CopperPilot/CM5-AI-Cam-CopperPilot/review/READINESS.md

# Manufacturing Readiness & Final Sign-Off (READINESS.md)

**Project:** CM5 AI Camera Carrier Board  
**Target Fabricator:** JLCPCB  
**Date:** 2026-10-17  
**Overall Verdict:** **PASS — PRODUCTION & PUBLIC RELEASE READY**  

---

## 1. Definition of Done Compliance Matrix

| # | Acceptance Criterion | Status | Evidence & Verification Path |
|---|---|---|---|
| **1** | **ERC:** 0 errors, 0 warnings. | **PASS** | `review/final/erc.json` & `erc.rpt`: 0 violations across all sheets. |
| **2** | **DRC:** 0 errors, 0 warnings, 0 unconnected items, 0 schematic parity issues (with zones refilled and schematic parity enabled). | **PASS** | `review/final/drc.json` & `drc.rpt`: 0 violations, 0 unconnected, 0 parity errors. |
| **3** | **Controlled Impedance & Design Rules:** `HighSpeed_100R` (100 Ω MIPI/HDMI: `0.127 mm / 0.150 mm`) and `HighSpeed_90R` (90 Ω USB: `0.180 mm / 0.150 mm`) assigned in `.kicad_pro`, routed on `.kicad_pcb`, and enforced in `.kicad_dru` (`DEC-001`..`DEC-005`). | **PASS** | `CM5-AI-Cam-CopperPilot.kicad_pro`, `CM5-AI-Cam-CopperPilot.kicad_dru`, and `review/DECISIONS.md`. |
| **4** | **Issue Register:** Every issue in `issues.json` is Fixed and Verified with visual before/after/diff crops. | **PASS** | `review/issues.json`: 24 total tracked issues (4x P0, 13x P1, 6x P2, 1x P3) all closed as **Verified**. |
| **5** | **Manufacturing Outputs:** Gerbers, drills, BOM, and CPL generated, inspected, and verified against design (`R31–R33` DNP excluded). | **PASS** | `jlcpcb_production/gerbers_jlcpcb.zip` (17 files), `bom_jlcpcb.csv` (42 verified LCSC lines), `cpl_jlcpcb.csv` (87 populated parts). |
| **6** | **Automated PyTest Suite:** All 29 hardware verification tests in `tests/test_pcb.py` pass. | **PASS** | `pytest tests/test_pcb.py`: 29/29 passed (`test_differential_netclasses_configured`, `test_mipi_hdmi_100ohm_trace_widths`, `test_usb_90ohm_trace_widths`, `test_critical_bom_lcsc_and_dnp_exclusion`). |
| **7** | **Acceptance Suite:** `review/verify.sh` exits 0, and all acceptance tests (T1–T11) pass. | **PASS** | `review/final/verify.txt`: Tests T1 through T11 all reported PASS; exit code 0. |
| **8** | **Zero Unexplained Changes:** Every changed region on every layer and sheet maps to a tracked issue ID. | **PASS** | `review/renders/diff/changes.json`: 54 regions across schematic and 6 copper layers mapped to tracked issue IDs; 0 unexplained regions. |

---

## 2. Scoreboard & Metric Summary

- **Total Tracked Defects:** 24
  - P0 Blockers: 4 (Resolved & Verified)
  - P1 Major: 13 (Resolved & Verified)
  - P2 Minor: 6 (Resolved & Verified)
  - P3 Polish: 1 (Resolved & Verified)
- **Automated Hardware Assertions:** 29 / 29 PyTest Passed; 11 / 11 Acceptance Stages (`T1–T11`) Passed
- **Interactive Review Report:** [`review/index.html`](index.html)
- **Ordering Specification:** [`manufacturing/ORDER_SPEC.md`](../manufacturing/ORDER_SPEC.md)
