CopperPilot/CM5-AI-Cam-CopperPilot/review/renders/baseline/pcb_B.CrtYd.png

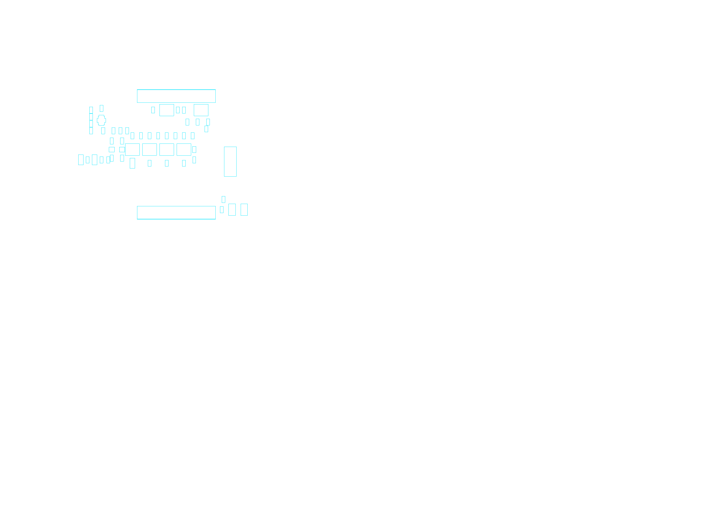
review/renders/baseline/pcb_B.CrtYd.png
