CopperPilot/CM5-AI-Cam-CopperPilot/review/renders/baseline/pcb_Edge.Cuts.png

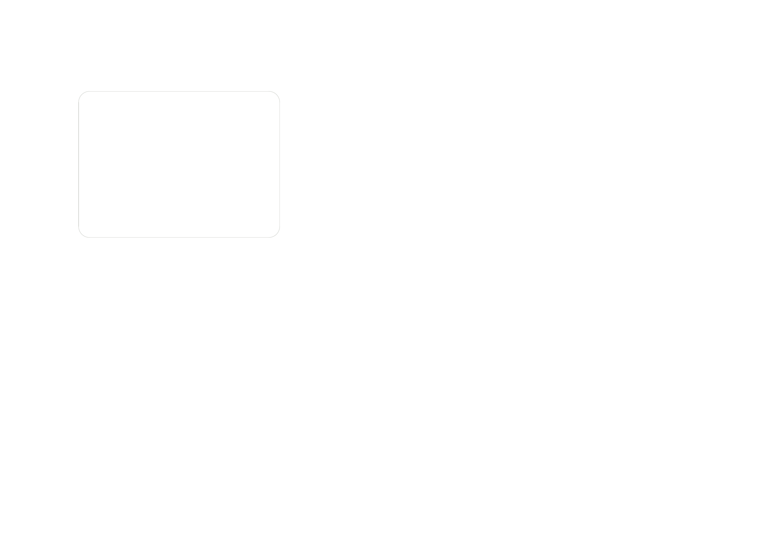
review/renders/baseline/pcb_Edge.Cuts.png
