CopperPilot/CM5-AI-Cam-CopperPilot/review/renders/baseline/sch_sheet_1.png

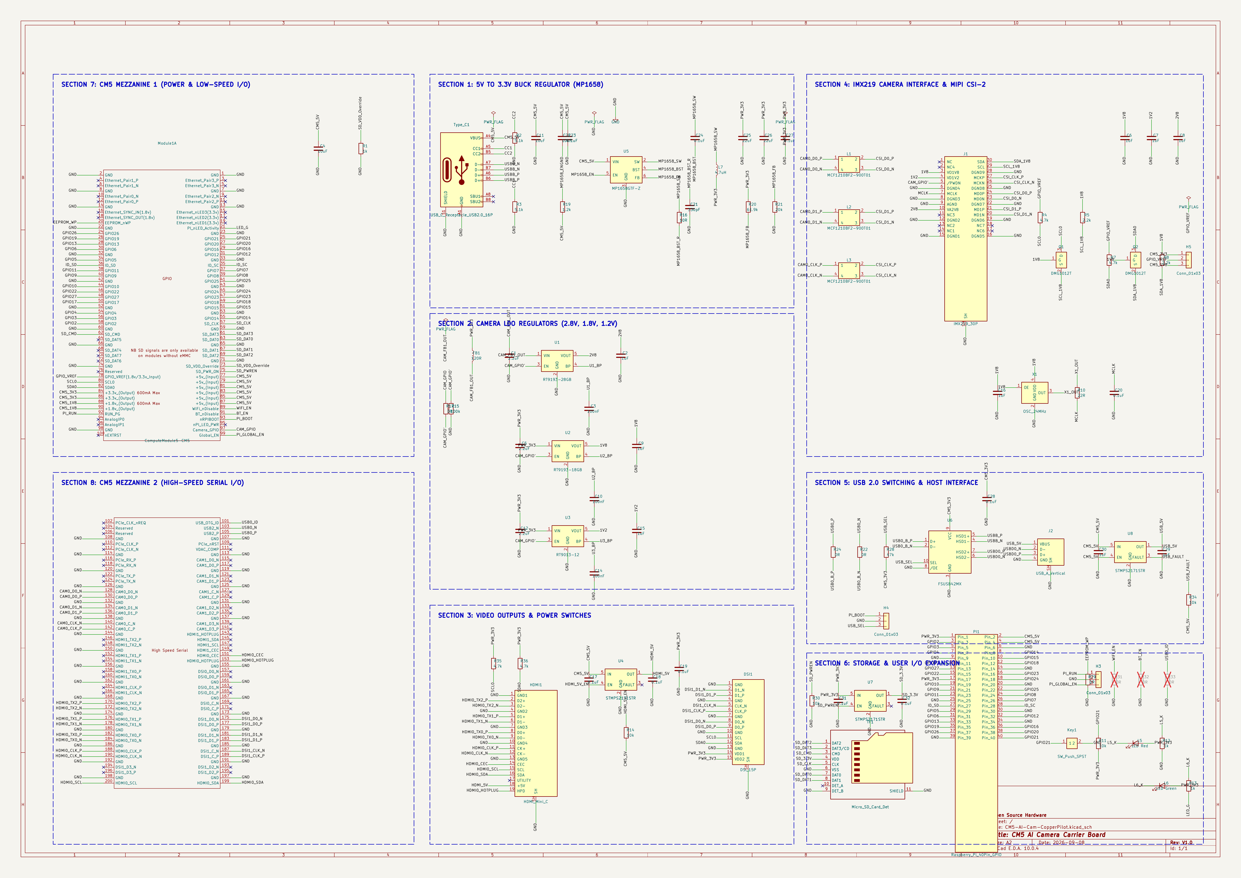
review/renders/baseline/sch_sheet_1.png
