CopperPilot/CM5-AI-Cam-CopperPilot/review/renders/diff/3d_bottom.png

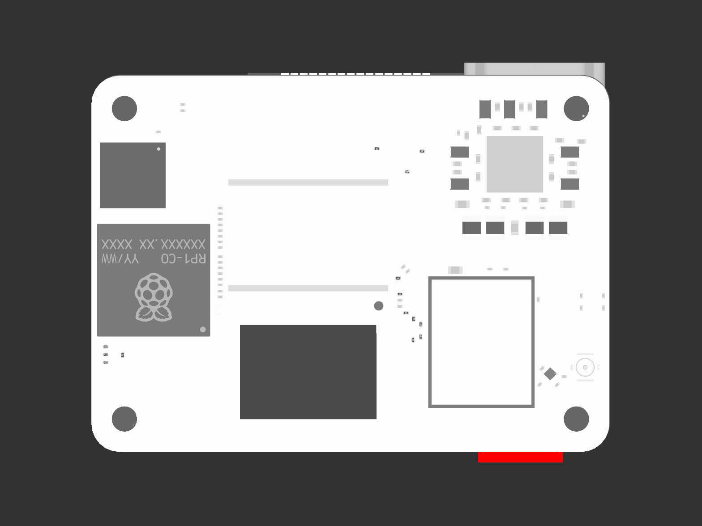
review/renders/diff/3d_bottom.png
