CopperPilot/CM5-AI-Cam-CopperPilot/jlcpcb_production/assembly/bom_jlcpcb.csv

Comment | Designator | Footprint | LCSC
2.2uF | C1,C5,C12 | C_0402_1005Metric | C23733
1uF | C2,C6,C7,C8,C9,C15,C16,C29,C30 | C_0402_1005Metric | C52923
0.1uF | C3,C10,C14,C17,C18,C19,C23,C24,C27,C28,C31,C32 | C_0402_1005Metric | C1525
10pF | C20 | C_0402_1005Metric | C32949
330pF | C21 | C_0402_1005Metric | C1534
10uF | C4,C11,C22 | C_0805_2012Metric | C15850
22uF | C25,C26 | C_0805_2012Metric | C45783
DSI_15P | DSI1 | Molex_200528-0150_1x15-1MP_P1.00mm_Horizontal | C2914074
120R | FB1 | R_0603_1608Metric | C50843
Conn_01x03 | H3,H4,H5 | PinHeader_1x03_P2.54mm_Vertical | C49257
HDMI_Mini_C | HDMI1 | HDMI_Mini-C_Molex_47151-0001 | C424662
IMX219_30P | J1 | Camera_Module_IMX219-D160 | C6539772
USB_A_Vertical | J2 | MOLEX_USB_67298-4090 | C698207
SW_Push_SPST | Key1 | SW_SPST_PTS645Sx43SMTR92 | C318884
MCF1210BF2-900T01 | L1,L2,L3 | L_CommonModeChoke_Coilank_ACM1210 | C110443
LED Red | L5 | LED_0603_1608Metric | C2286
LED Green | L6 | LED_0603_1608Metric | C72043
4.7uH | L7 | L_Bourns_SRP5030CC | C840574
ComputeModule5-CM5 | Module1 | Raspberry-Pi-5-Compute-Module | C597931
Raspberry_Pi_40Pin_GPIO | PI1 | PinHeader_2x20_P2.54mm_Vertical | C50980
DMG1012T | Q1,Q2 | SOT-523 | C20512
5.1k | R2,R3 | R_0402_1005Metric | C25905
2.2k | R5,R8 | R_0402_1005Metric | C25879
22R | R10 | R_0402_1005Metric | C25092
1k | R12,R13 | R_0402_1005Metric | C11702
10k | R11,R14,R30,R34 | R_0402_1005Metric | C25744
10R | R16 | R_0402_1005Metric | C25077
100k | R15,R19 | R_0402_1005Metric | C25741
61.9k | R20 | R_0402_1005Metric | C25803
20k | R21 | R_0402_1005Metric | C25765
47k | R28 | R_0402_1005Metric | C25792
0R | R1,R17,R22,R24,R29 | R_0402_1005Metric | C17168
4.7k | R4,R7,R35,R36 | R_0402_1005Metric | C25900
Micro_SD_Card_Det | TF1 | SDCARD_MOLEX_503398-1892 | C91145
USB_C_Receptacle_USB2.0_16P | Type_C1 | USB_C_Receptacle_GCT_USB4105-xx-A_16P_TopMnt_Horizontal | C3020560
RT9193-28GB | U1 | SOT-23-5 | C15075
RT9193-18GB | U2 | SOT-23-5 | C27416
RT9013-12 | U3 | SOT-23-5 | C47773
MP1658GTF-Z | U5 | SOT-563 | C2960187
FSUSB42UMX | U6 | UQFN-10_1.4x1.8mm_P0.4mm | C11145
STMPS2171STR | U4,U7,U8 | SOT-23-5 | C157437
OSC_24MHz | X1 | Crystal_SMD_3225-4Pin_3.2x2.5mm | C717686
