CopperPilot/CM5-AI-Cam-CopperPilot/3dmodels/Camera_IMX219-D160.step

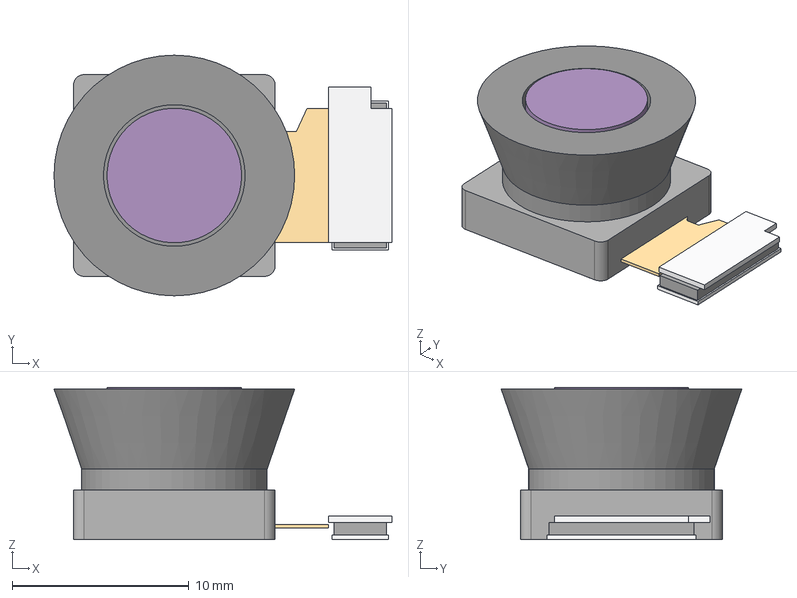
[picture p11: CAD file, 2026-10-18]
3dmodels/Camera_IMX219-D160.step
19.1 x 13.6 x 8.60 mm
receptacle_part
tabs_part
stiffener_part
ribbon_part
cam_base_part
collar_part
cone_part
lens_glass_part
