CopperPilot/CM5-AI-Cam-CopperPilot/3dmodels/USB_A_Molex_105057-0001_Vertical.step

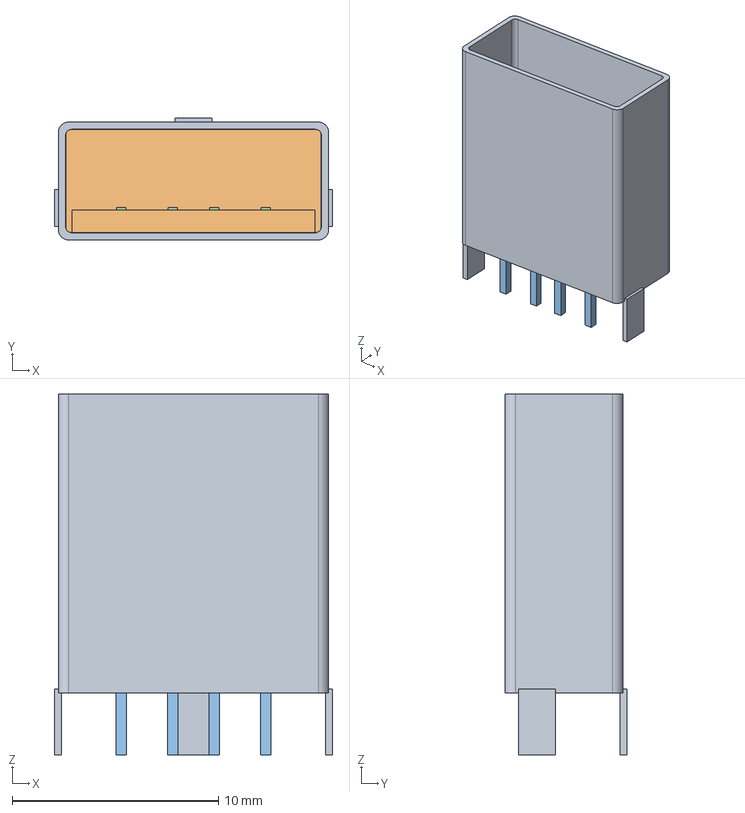
[picture p12: CAD file, 2026-10-18]
3dmodels/USB_A_Molex_105057-0001_Vertical.step
13.5 x 5.92 x 17.5 mm
