CopperPilot/CM5-AI-Cam-CopperPilot/(list of files, cad)

Other CAD files:
3dmodels/CM4Lite.step
3dmodels/CM4.step
