CopperPilot/CM5-AI-Cam-CopperPilot/review/ISSUES.md

# Review Issue Register

| ID | Sev | Domain | Location | Finding | Standard / Rule | Root Cause | Proposed Fix | Functional? | Status |
|---|---|---|---|---|---|---|---|---|---|
| SCH-001 | P1 | SCH | `DSI1, sheet 1 @(382, 395)mm` | DSI1 symbol pin SH (GND) had no matching pad on footprint Molex_200528-0150 (pads are MP). | KiCad DRC net_conflict, /schematic-engineer section Design sequence | DSI_15P symbol included legacy non-connector pin SH while physical 15-pin FPC connector uses 15 signal circuits. | Remove unrouted pin SH and dangling wire stub in symbol library and schematic to match 15-pin connector. | N | **Verified** |
| PCB-001 | P0 | PCB | `Type_C1, F.Cu @(31.0, 62.5)mm` | Type_C1 USB Type-C connector tagged as DNP on PCB footprint, omitting main power entry from PCBA. | JLCPCB assembly checklist, /pcb-dfm-engineer | PCB footprint carried legacy (attr smd dnp) attribute override. | Update PCB footprint attribute from (attr smd dnp) to (attr smd). | N | **Verified** |
| PCB-002 | P1 | PCB | `C19, F.Cu @(42.0, 33.0)mm` | C19 0.1uF 3.3V decoupling capacitor tagged as DNP on PCB footprint. | Schematic-PCB parity, /pcb-power-integrity | PCB footprint carried legacy (attr smd dnp) attribute override. | Update PCB footprint attribute from (attr smd dnp) to (attr smd). | N | **Verified** |
| PCB-003 | P1 | PCB | `R36, F.Cu @(44.0, 33.0)mm` | R36 4.7k pull-up resistor tagged as DNP on PCB footprint. | Schematic-PCB parity, /schematic-engineer | PCB footprint carried legacy (attr smd dnp) attribute override. | Update PCB footprint attribute from (attr smd dnp) to (attr smd). | N | **Verified** |
| PCB-004 | P1 | PCB | `Q1, Q2, B.Cu @(34.0, 43.5)mm` | Q1 and Q2 footprints on PCB were Texas_DRT-3 instead of SOT-523 given by symbol. | JLCPCB PCBA footprint parity, /pcb-dfm-engineer | Footprint link misconfigured to TVS diode package instead of SOT-523. | Update Q1 and Q2 footprints on PCB to CM5:SOT-523. | N | **Verified** |
| PCB-005 | P1 | PCB | `U5, F.Cu @(66.1, 40.5)mm` | U5 buck regulator footprint on PCB was TSOT-23-6 instead of SOT-563, and LCSC was C2837379 (LED) instead of C2960187 (MP1658GTF-Z). | JLCPCB PCBA package parity, /pcb-dfm-engineer | PCB footprint carried TSOT-23-6 while symbol and BOM specify SOT-563 (LCSC C2837379). | Harmonize U5 footprint to CM5:SOT-563 and LCSC to C2960187 (MPS MP1658GTF-Z). | N | **Verified** |
| PCB-006 | P1 | PCB | `U4, U7, B.Cu @(51.0, 38.0)mm` | U4 and U7 value on PCB was DIO7003HCST5 while schematic specifies STMPS2171STR. | Schematic-PCB parity, /schematic-engineer | Alternate second-source MPN DIO7003HCST5 entered on PCB while schematic and BOM use primary STMPS2171STR (both LCSC C157437). | Update PCB footprint Value to STMPS2171STR on U4 and U7. | N | **Verified** |
| PCB-007 | P1 | PCB | `C20, F.Cu @(63.0, 38.5)mm` | C20 24 MHz MCLK filter capacitor had 0.1uF (C1525) in schematic (72.3 kHz cutoff attenuating 24 MHz clock) while PCB specified 10pF (C32949, fc=723 MHz). | Schematic-PCB parity, /schematic-engineer | PCB footprint Value and LCSC field diverged from schematic netlist. | Synchronize C20 Value to 10pF and LCSC to C32949 across schematic, PCB, and BOM. | N | **Verified** |
| PCB-008 | P1 | PCB | `C21, F.Cu @(65.0, 37.5)mm` | C21 SW-node snubber capacitor was 1uF (C52923) on PCB and had 12pF LCSC code (C1547) for 330pF in schematic. | Schematic-PCB parity, /schematic-engineer | PCB footprint Value and LCSC field diverged from schematic netlist. | Synchronize C21 Value to 330pF and LCSC to C1534 across schematic, PCB, and BOM. | N | **Verified** |
| SCH-002 | P2 | SCH | `R1, sheet 1 @(187, 77)mm` | R1 schematic symbol value and LCSC field differed from PCB and BOM. | BOM completeness, /pcb-dfm-engineer | Alternate 0R resistor LCSC part number entered in schematic. | Update schematic symbol R1 Value to 0R and LCSC property to C17168. | N | **Verified** |
| SCH-003 | P2 | SCH | `R19, sheet 1 @(290, 107)mm` | R19 schematic symbol value and LCSC field differed from PCB and BOM. | BOM completeness, /pcb-dfm-engineer | Alternate 100k resistor LCSC part number entered in schematic. | Update schematic symbol R19 Value to 100k and LCSC property to C25741. | N | **Verified** |
| PCB-009 | P2 | PCB | `J2, F.Cu @(65.0, 31.5)mm` | J2 USB-A connector LCSC field on PCB was C720523 while schematic and BOM specify C698207. | BOM completeness, /pcb-dfm-engineer | PCB footprint carried alternate supplier LCSC code. | Update PCB footprint J2 LCSC property to C698207. | N | **Verified** |
| PCB-010 | P3 | DOC | `Module1, F.Cu @(72.8, 61.4)mm` | Module1 description on PCB was Unit 2 instead of Unit 1. | /schematic-conventions, /pcb-design-reviewer | Description text field mismatch on multi-unit CM5 module. | Synchronize Description field on PCB footprint to match schematic. | N | **Verified** |
| DFM-001 | P0 | DFM | `CM5-AI-Cam-CopperPilot.kicad_dru` | Custom rules in .kicad_dru lacked explicit Decision references for JLCPCB edge connectors and via spacing. | Section 3 & Section 9.3 JLCPCB constraint targets | Custom DRC rules lacked formal Decision ID annotations. | Annotate custom rules with formal Decision IDs (DEC-001..004) and verify all clearances. | N | **Verified** |
| DOC-001 | P2 | DOC | `manufacturing/ORDER_SPEC.md, README.md, LICENSE` | Missing manufacturing ordering specification, project documentation, and open source license. | Section 10 Release package and exit criteria | Pre-release repository lacked standardized release collateral. | Create manufacturing/ORDER_SPEC.md, README.md, and LICENSE (CERN-OHL-S). | N | **Verified** |
| IMP-001 | P0 | PCB | `MIPI CSI-2, DSI, HDMI & USB Differential Pairs, F.Cu @(21.5, 25.0)mm` | HighSpeed_100R (100 Ohm MIPI/HDMI) and HighSpeed_90R (90 Ohm USB) netclasses were unassigned in .kicad_pro, and MIPI/HDMI pairs on F.Cu were routed at 0.150mm Default width instead of 0.127mm (100 Ohm). | Raspberry Pi CM5 Datasheet, MIPI D-PHY / HDMI 1.4b (100R diff) & USB 2.0 (90R diff), JLCPCB JLC06161H-7628 | Netclass patterns were cleared in .kicad_pro and MIPI/HDMI traces left at Default 0.150mm width while USB traces were 0.180mm. | Assign HighSpeed_100R (0.127mm/0.150mm, 100.1 Ohm) to MIPI/HDMI and HighSpeed_90R (0.180mm/0.150mm, 89.6 Ohm) to USB in .kicad_pro, update MIPI/HDMI traces to 0.127mm, and enforce widths in .kicad_dru. | N | **Verified** |
| IMP-002 | P1 | PCB | `MIPI CSI-2 & HDMI Differential Pairs, In1.Cu @(21.5, 25.0)mm` | Inner layer In1.Cu MIPI CSI-2 and HDMI differential segments were routed at 0.150mm Default width instead of 0.127mm HighSpeed_100R width. | HighSpeed_100R 100 Ohm differential impedance specification | Unassigned HighSpeed_100R netclass during initial routing. | Update In1.Cu HighSpeed_100R differential segments to 0.127mm and refill GND zone. | N | **Verified** |
| IMP-003 | P1 | PCB | `HDMI TMDS & MIPI DSI Striplines, In2.Cu @(21.5, 25.0)mm` | Inner stripline layer In2.Cu HDMI TMDS and MIPI DSI differential traces were 0.150mm (95.2 Ohm on JLC06161H-7628 / 80.5 Ohm on 3313) instead of 0.127mm (100.1 Ohm). | JLCPCB JLC06161H-7628 100 Ohm stripline specification (W=0.127mm, S=0.150mm -> Zdiff=100.1 Ohm) | Traces routed with Default 0.150mm width instead of HighSpeed_100R 0.127mm width. | Update In2.Cu HighSpeed_100R stripline segments to 0.127mm and synchronize .kicad_pcb stackup with JLC06161H-7628. | N | **Verified** |
| IMP-004 | P1 | PCB | `MIPI CSI-2 & HDMI Differential Pairs, In3.Cu @(21.5, 25.0)mm` | Inner layer In3.Cu MIPI CSI-2 and HDMI differential segments were routed at 0.150mm instead of 0.127mm HighSpeed_100R width. | HighSpeed_100R 100 Ohm differential impedance specification | Unassigned HighSpeed_100R netclass during initial routing. | Update In3.Cu HighSpeed_100R segments to 0.127mm and refill power zones. | N | **Verified** |
| IMP-005 | P1 | PCB | `HDMI TMDS Differential Pairs, In4.Cu @(21.5, 25.0)mm` | Inner layer In4.Cu HDMI TMDS differential segments (/HDMI0_CLK_P, /HDMI0_TX0_P, /HDMI0_TX2_P) were routed at 0.150mm instead of 0.127mm HighSpeed_100R width while USB (/USB0_P, /USBD0_P/N) used 0.180mm HighSpeed_90R width. | HighSpeed_100R (0.127mm) vs HighSpeed_90R (0.180mm) separation | Unassigned HighSpeed_100R netclass during initial routing. | Update In4.Cu HighSpeed_100R HDMI segments to 0.127mm while preserving 0.180mm HighSpeed_90R USB segments. | N | **Verified** |
| IMP-006 | P1 | PCB | `Mezzanine High-Speed Escapes, B.Cu @(21.5, 25.0)mm` | Bottom layer B.Cu MIPI CSI-2, DSI, and HDMI differential escape segments were 0.150mm instead of 0.127mm HighSpeed_100R width. | HighSpeed_100R 100 Ohm differential impedance specification | Unassigned HighSpeed_100R netclass during initial routing. | Update B.Cu HighSpeed_100R escape segments to 0.127mm while keeping USB 2.0 segments at 0.180mm. | N | **Verified** |
| SCH-004 | P0 | SCH | `C20, R20, U1, U3, U5, C21, HDMI1, L1-L3, sheet 1 @(533, 188)mm` | C20 on 24 MHz camera MCLK was 0.1uF (72.3 kHz low-pass cutoff attenuating MCLK) instead of 10pF (C32949, fc=723 MHz); critical LCSC mismatches on R20 (C25916 6.49k -> 1.07V buck output), U3 (C7434207 3.3V LDO on 1.2V core), U1 (invalid C114059), U5 (C2837379 LED), HDMI1 (C2013978 oscillator), L1-L3 (C49073870 3.2x2.5mm choke), C21 (C1547 12pF), and DNP R31-R33 in BOM/CPL. | Sony IMX219 MCLK spec, MPS MP1658 & Richtek RT9013/RT9193 datasheets, JLCPCB PCBA BOM verification | C20 was harmonized to 0.1uF instead of 10pF; incorrect supplier LCSC codes entered in schematic/BOM; pos export omitted --exclude-dnp. | Restore C20 to 10pF (C32949), update LCSC codes (R20->C25803, U3->C47773, U1->C15075, U5->C2960187, HDMI1->C424662, L1-L3->C110443, C21->C1534), standardize C3/C10/C14 to 0.1uF, and exclude DNP R31-R33. | N | **Verified** |
| SCH-005 | P2 | SCH | `U6 (FSUSB42UMX), sheet 1 @(455, 264)mm` | U6 value was FSUSB42MX (MSOP-10 package suffix) while footprint is UQFN-10_1.4x1.8mm_P0.4mm and LCSC is C11145 (FSUSB42UMX). | Schematic-to-BOM MPN and package parity | Generic FSUSB42MX family name entered instead of UMLP-10/UQFN-10 suffix FSUSB42UMX. | Update U6 Value to FSUSB42UMX across schematic, PCB, BOM, CPL, and documentation. | N | **Verified** |
| IMP-007 | P1 | SCH | `Netclass Patterns (HighSpeed_100R, HighSpeed_90R, Power), sheet 1 @(25, 50)mm` | CM5-AI-Cam-CopperPilot.kicad_pro had empty netclass_patterns=[], leaving all MIPI CSI-2, MIPI DSI, HDMI TMDS, USB 2.0, and Power nets in Default netclass. | 100 Ohm MIPI/HDMI (HighSpeed_100R) and 90 Ohm USB (HighSpeed_90R) netclass separation | Netclass assignment patterns were omitted from .kicad_pro. | Assign /CAM0_*, /CSI_*, /DSI1_*, /HDMI0_CLK_*, /HDMI0_TX* to HighSpeed_100R, /USB0_P/N, /USB0_B_*, /USBB_*, /USBD0_* to HighSpeed_90R, and power rails to Power in .kicad_pro. | N | **Verified** |
