CopperPilot/CM5-AI-Cam-CopperPilot/review/renders/issues/DOC-001/after.png

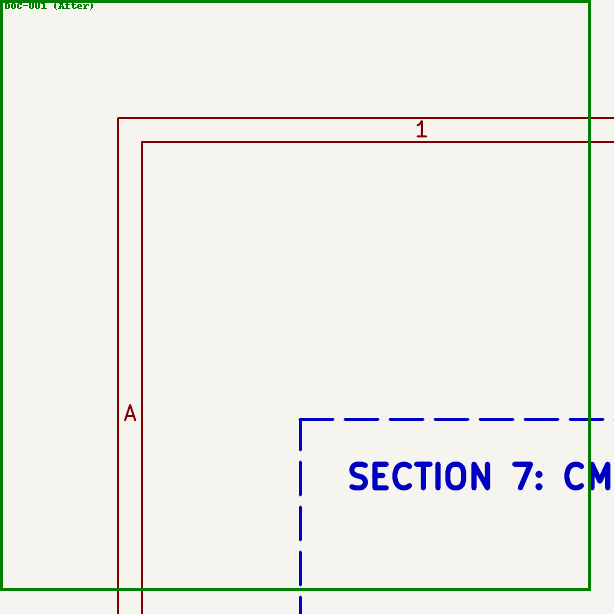
review/renders/issues/DOC-001/after.png
