CopperPilot/CM5-AI-Cam-CopperPilot/review/renders/issues/IMP-001/after.png

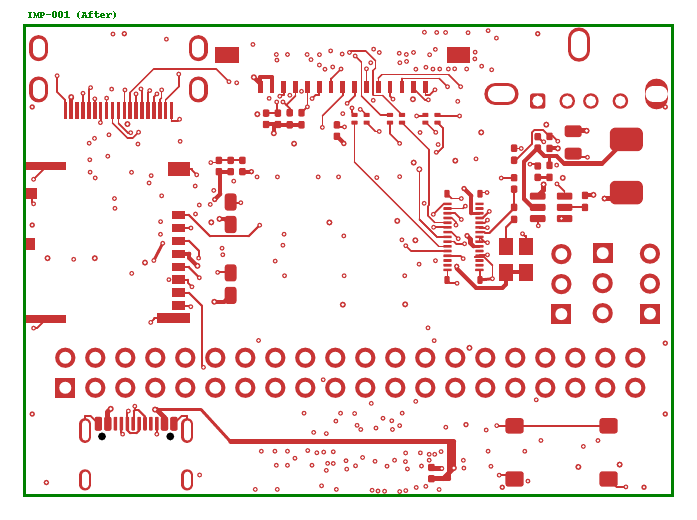
review/renders/issues/IMP-001/after.png
