CopperPilot/CM5-AI-Cam-CopperPilot/review/renders/issues/IMP-005/after.png

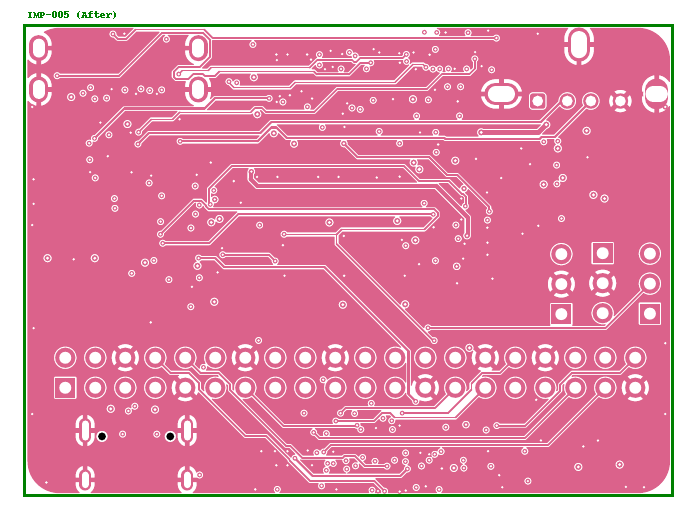
review/renders/issues/IMP-005/after.png
