CopperPilot/CM5-AI-Cam-CopperPilot/review/renders/issues/IMP-006/after.png

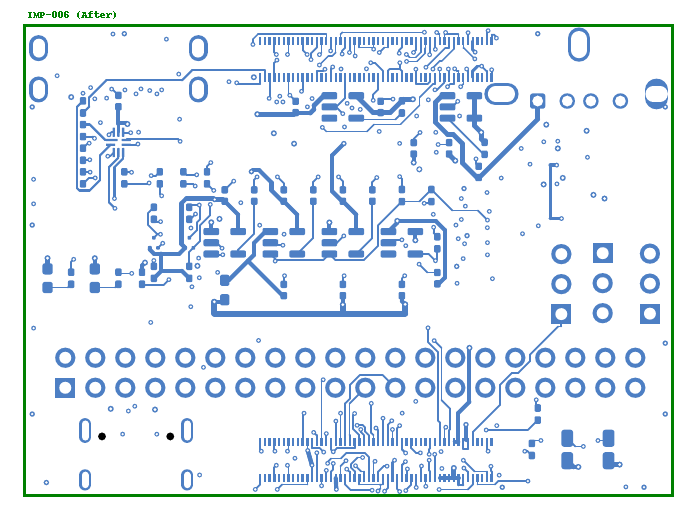
review/renders/issues/IMP-006/after.png
