CopperPilot/CM5-AI-Cam-CopperPilot/review/renders/issues/PCB-001/after.png

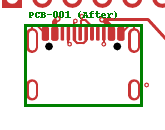
review/renders/issues/PCB-001/after.png
