CopperPilot/CM5-AI-Cam-CopperPilot/review/renders/issues/PCB-004/after.png

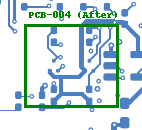
review/renders/issues/PCB-004/after.png
