CopperPilot/CM5-AI-Cam-CopperPilot/review/renders/issues/PCB-006/diff.png

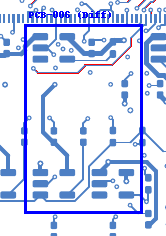
review/renders/issues/PCB-006/diff.png
