CopperPilot/CM5-AI-Cam-CopperPilot/review/renders/issues/PCB-009/after.png

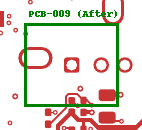
review/renders/issues/PCB-009/after.png
