CopperPilot/CM5-AI-Cam-CopperPilot/review/renders/issues/SCH-002/after.png

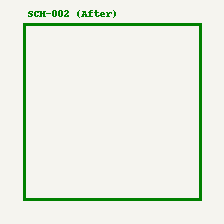
review/renders/issues/SCH-002/after.png
