CopperPilot/CM5-AI-Cam-CopperPilot/review/renders/issues/SCH-004/after.png

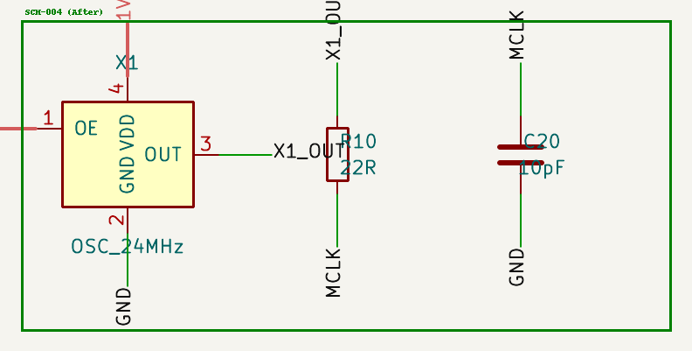
review/renders/issues/SCH-004/after.png
