CopperPilot/CM5-AI-Cam-CopperPilot/review/renders/issues/SCH-005/after.png

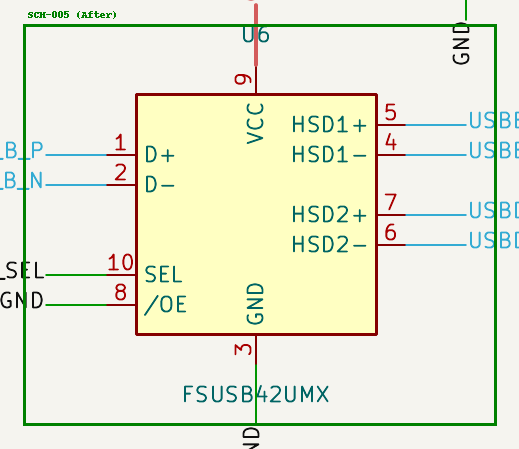
review/renders/issues/SCH-005/after.png
