CopperPilot/CM5-AI-Cam-CopperPilot/review/renders/final/schematic.pdf

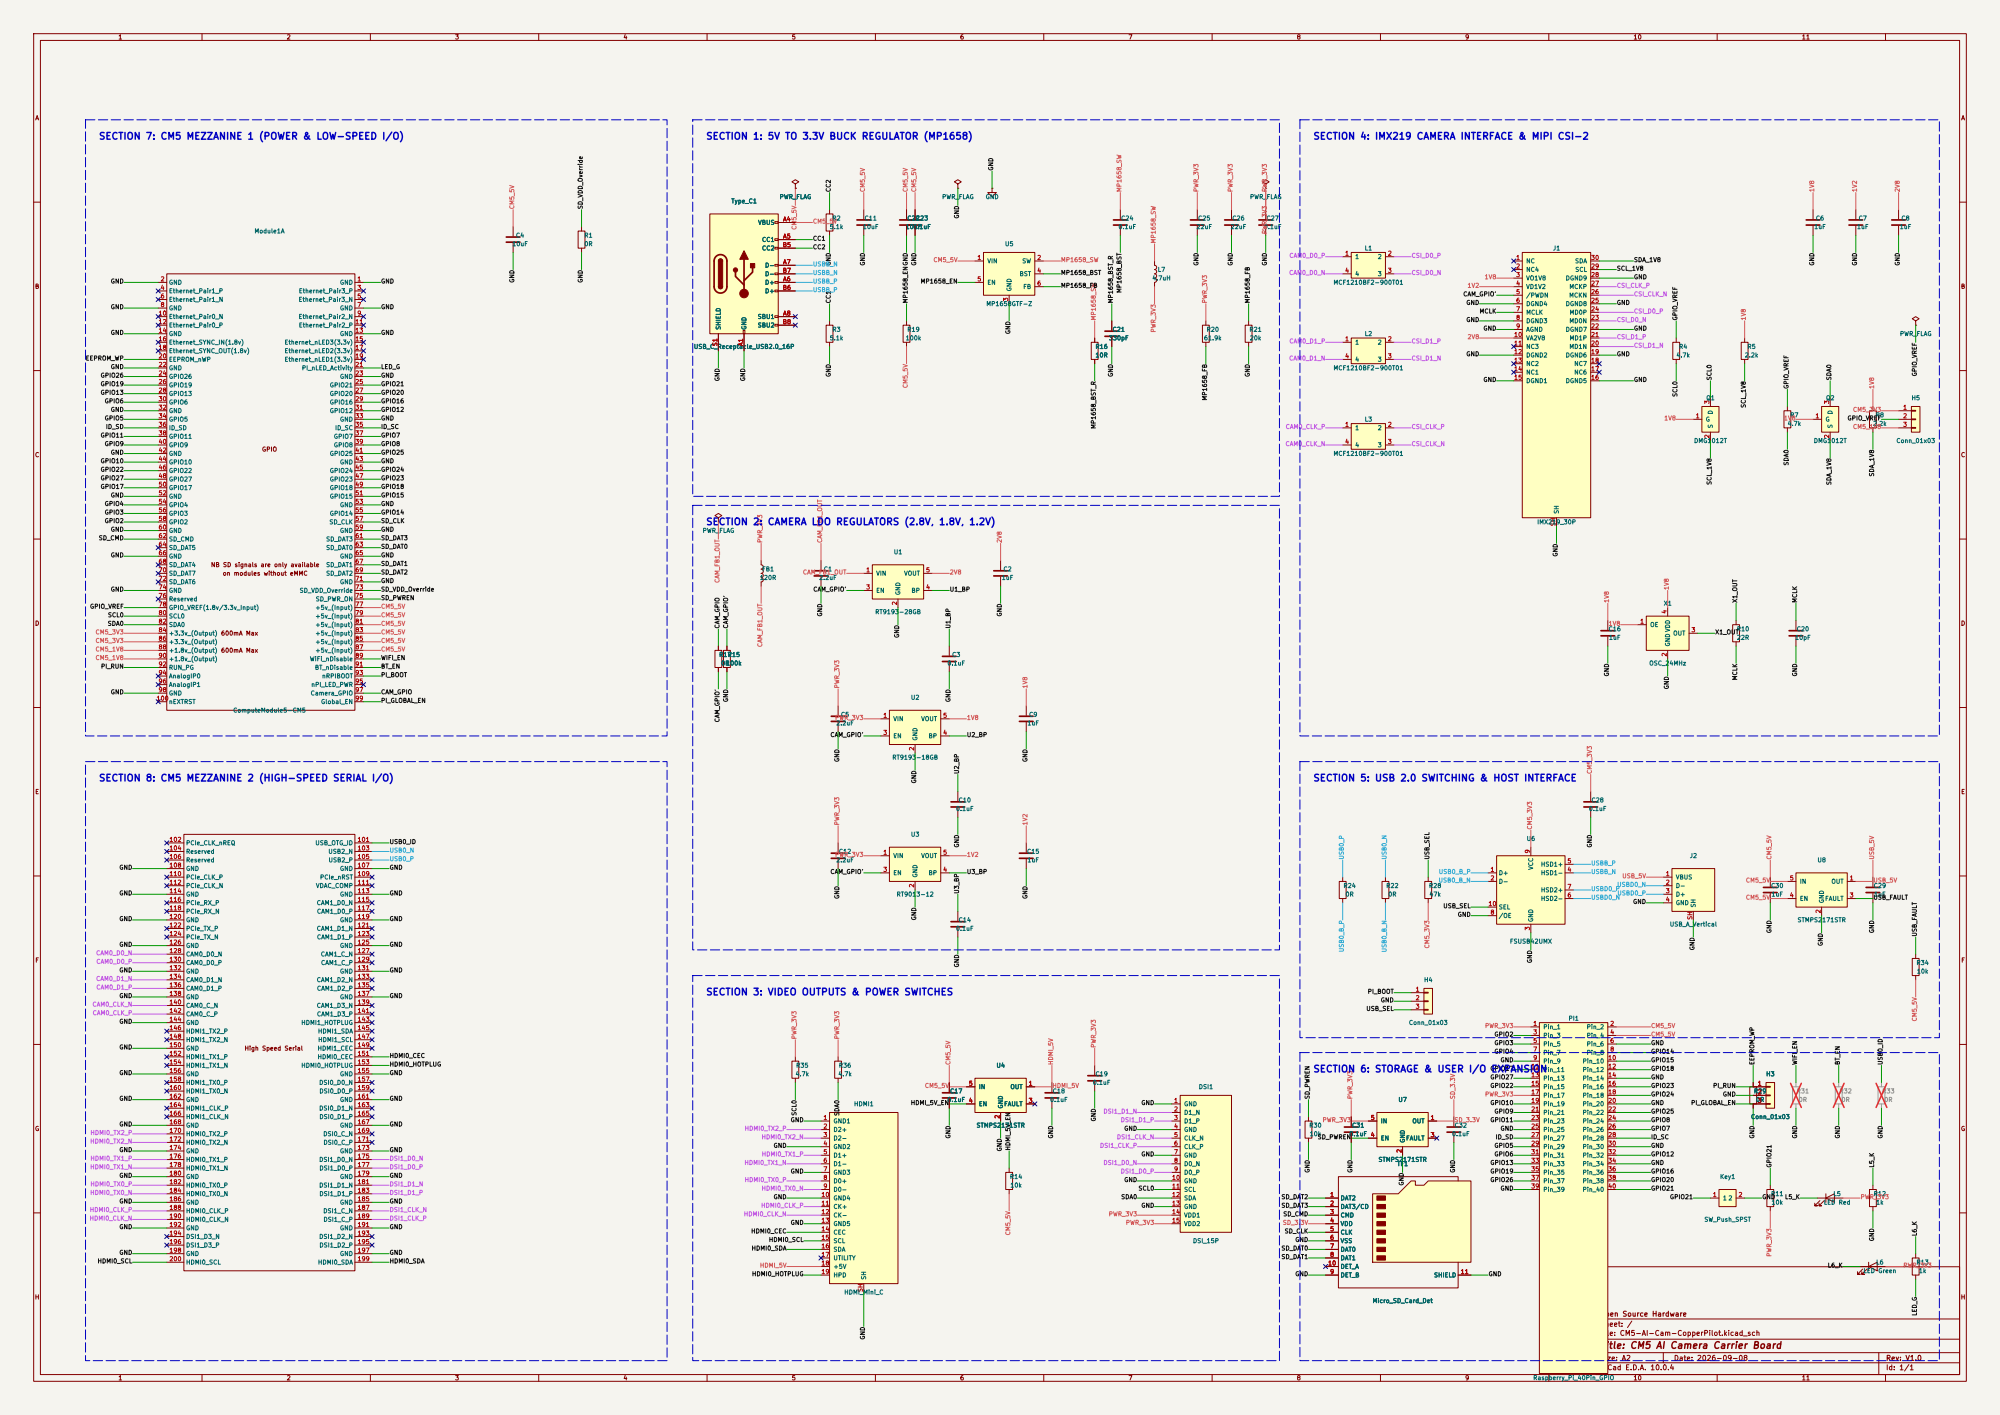
[picture p32: page 1]

SECTION 7: CM5 MEZZANINE 1 (POWER & LOW-SPEED I/O)

10uF 600mA Max 600mA Max NB SD signals are only available on modules without eMMC

SECTION 2: CAMERA LDO REGULATORS (2.8V, 1.8V, 1.2V)

PWR_FLAG

SECTION 8: CM5 MEZZANINE 2 (HIGH-SPEED SERIAL I/O)

SECTION 3: VIDEO OUTPUTS & POWER SWITCHES

SECTION 6: STORAGE & USER I/O EXPANSION

Open Source Hardware
Sheet: / File: CM5-AI-Cam-CopperPilot.kicad_sch

Title: CM5 AI Camera Carrier Board
Size: A2 | Rev: V1.0
KiCad E.D.A. 10.0.4 | Id: 1/1
