CopperPilot/CM5-AI-Cam-CopperPilot/review/renders/baseline/schematic.pdf

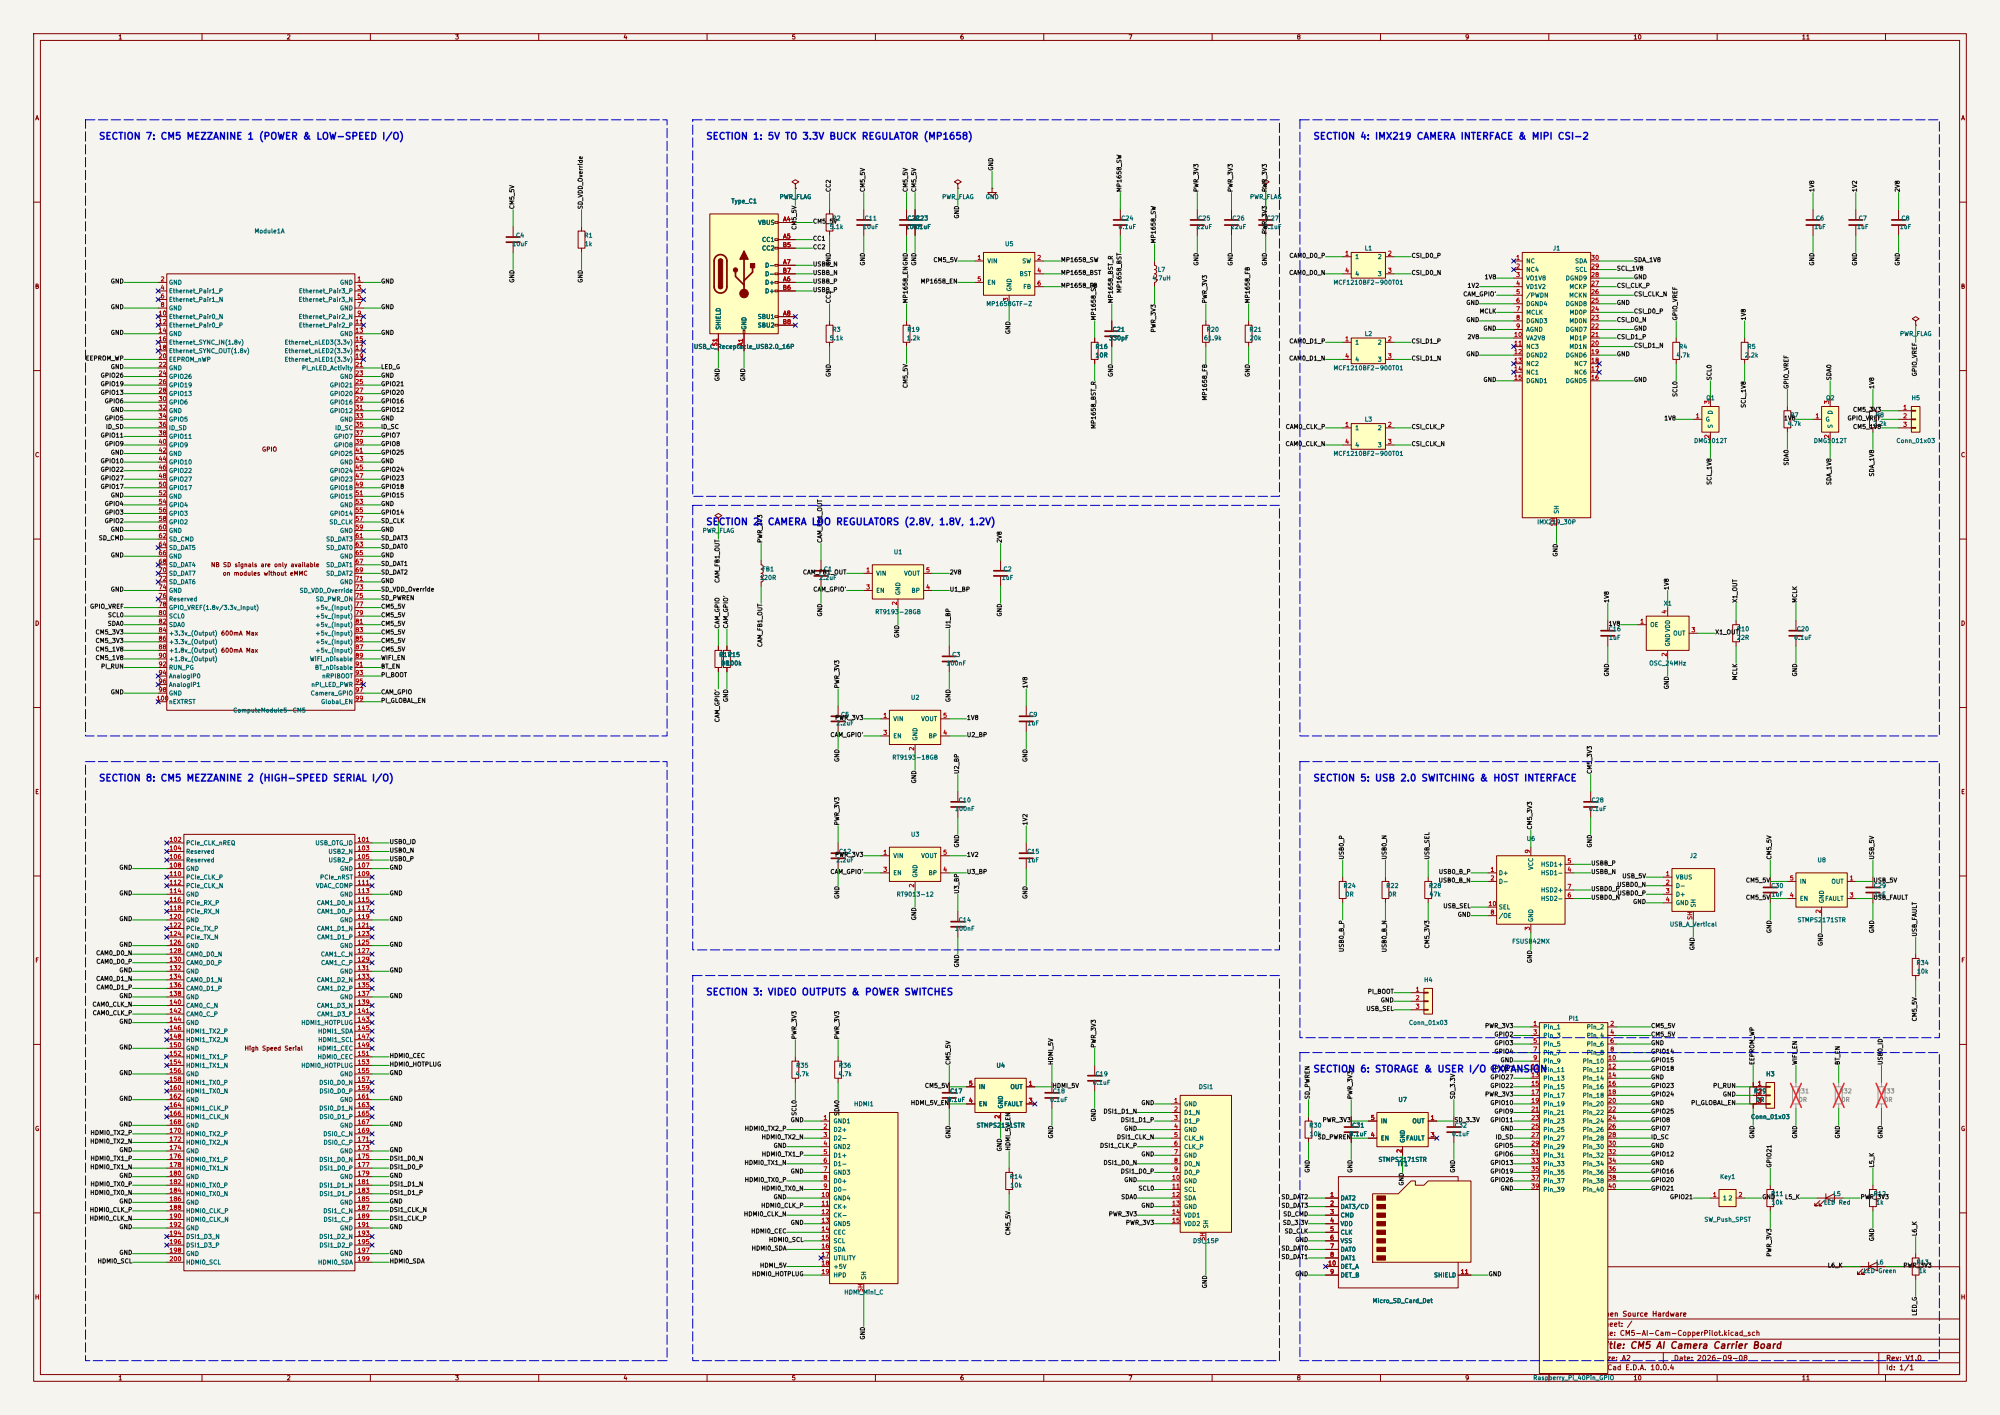
[picture p33: page 1]

SECTION 2: CAMERA LDO REGULATORS (2.8V, 1.8V, 1.2V)

600mA Max 600mA Max NB SD signals are only available on modules without eMMC

SECTION 8: CM5 MEZZANINE 2 (HIGH-SPEED SERIAL I/O)

SECTION 5: USB 2.0 SWITCHING & HOST INTERFACE

SECTION 3: VIDEO OUTPUTS & POWER SWITCHES

SECTION 6: STORAGE & USER I/O EXPANSION

Open Source Hardware
Sheet: / File: CM5-AI-Cam-CopperPilot.kicad_sch

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
