CopperPilot/CM5-AI-Cam-CopperPilot/CM5-AI-Cam-CopperPilot.kicad_pcb

## KiCad design CM5-AI-Cam-CopperPilot.kicad_pcb (2026-10-20)

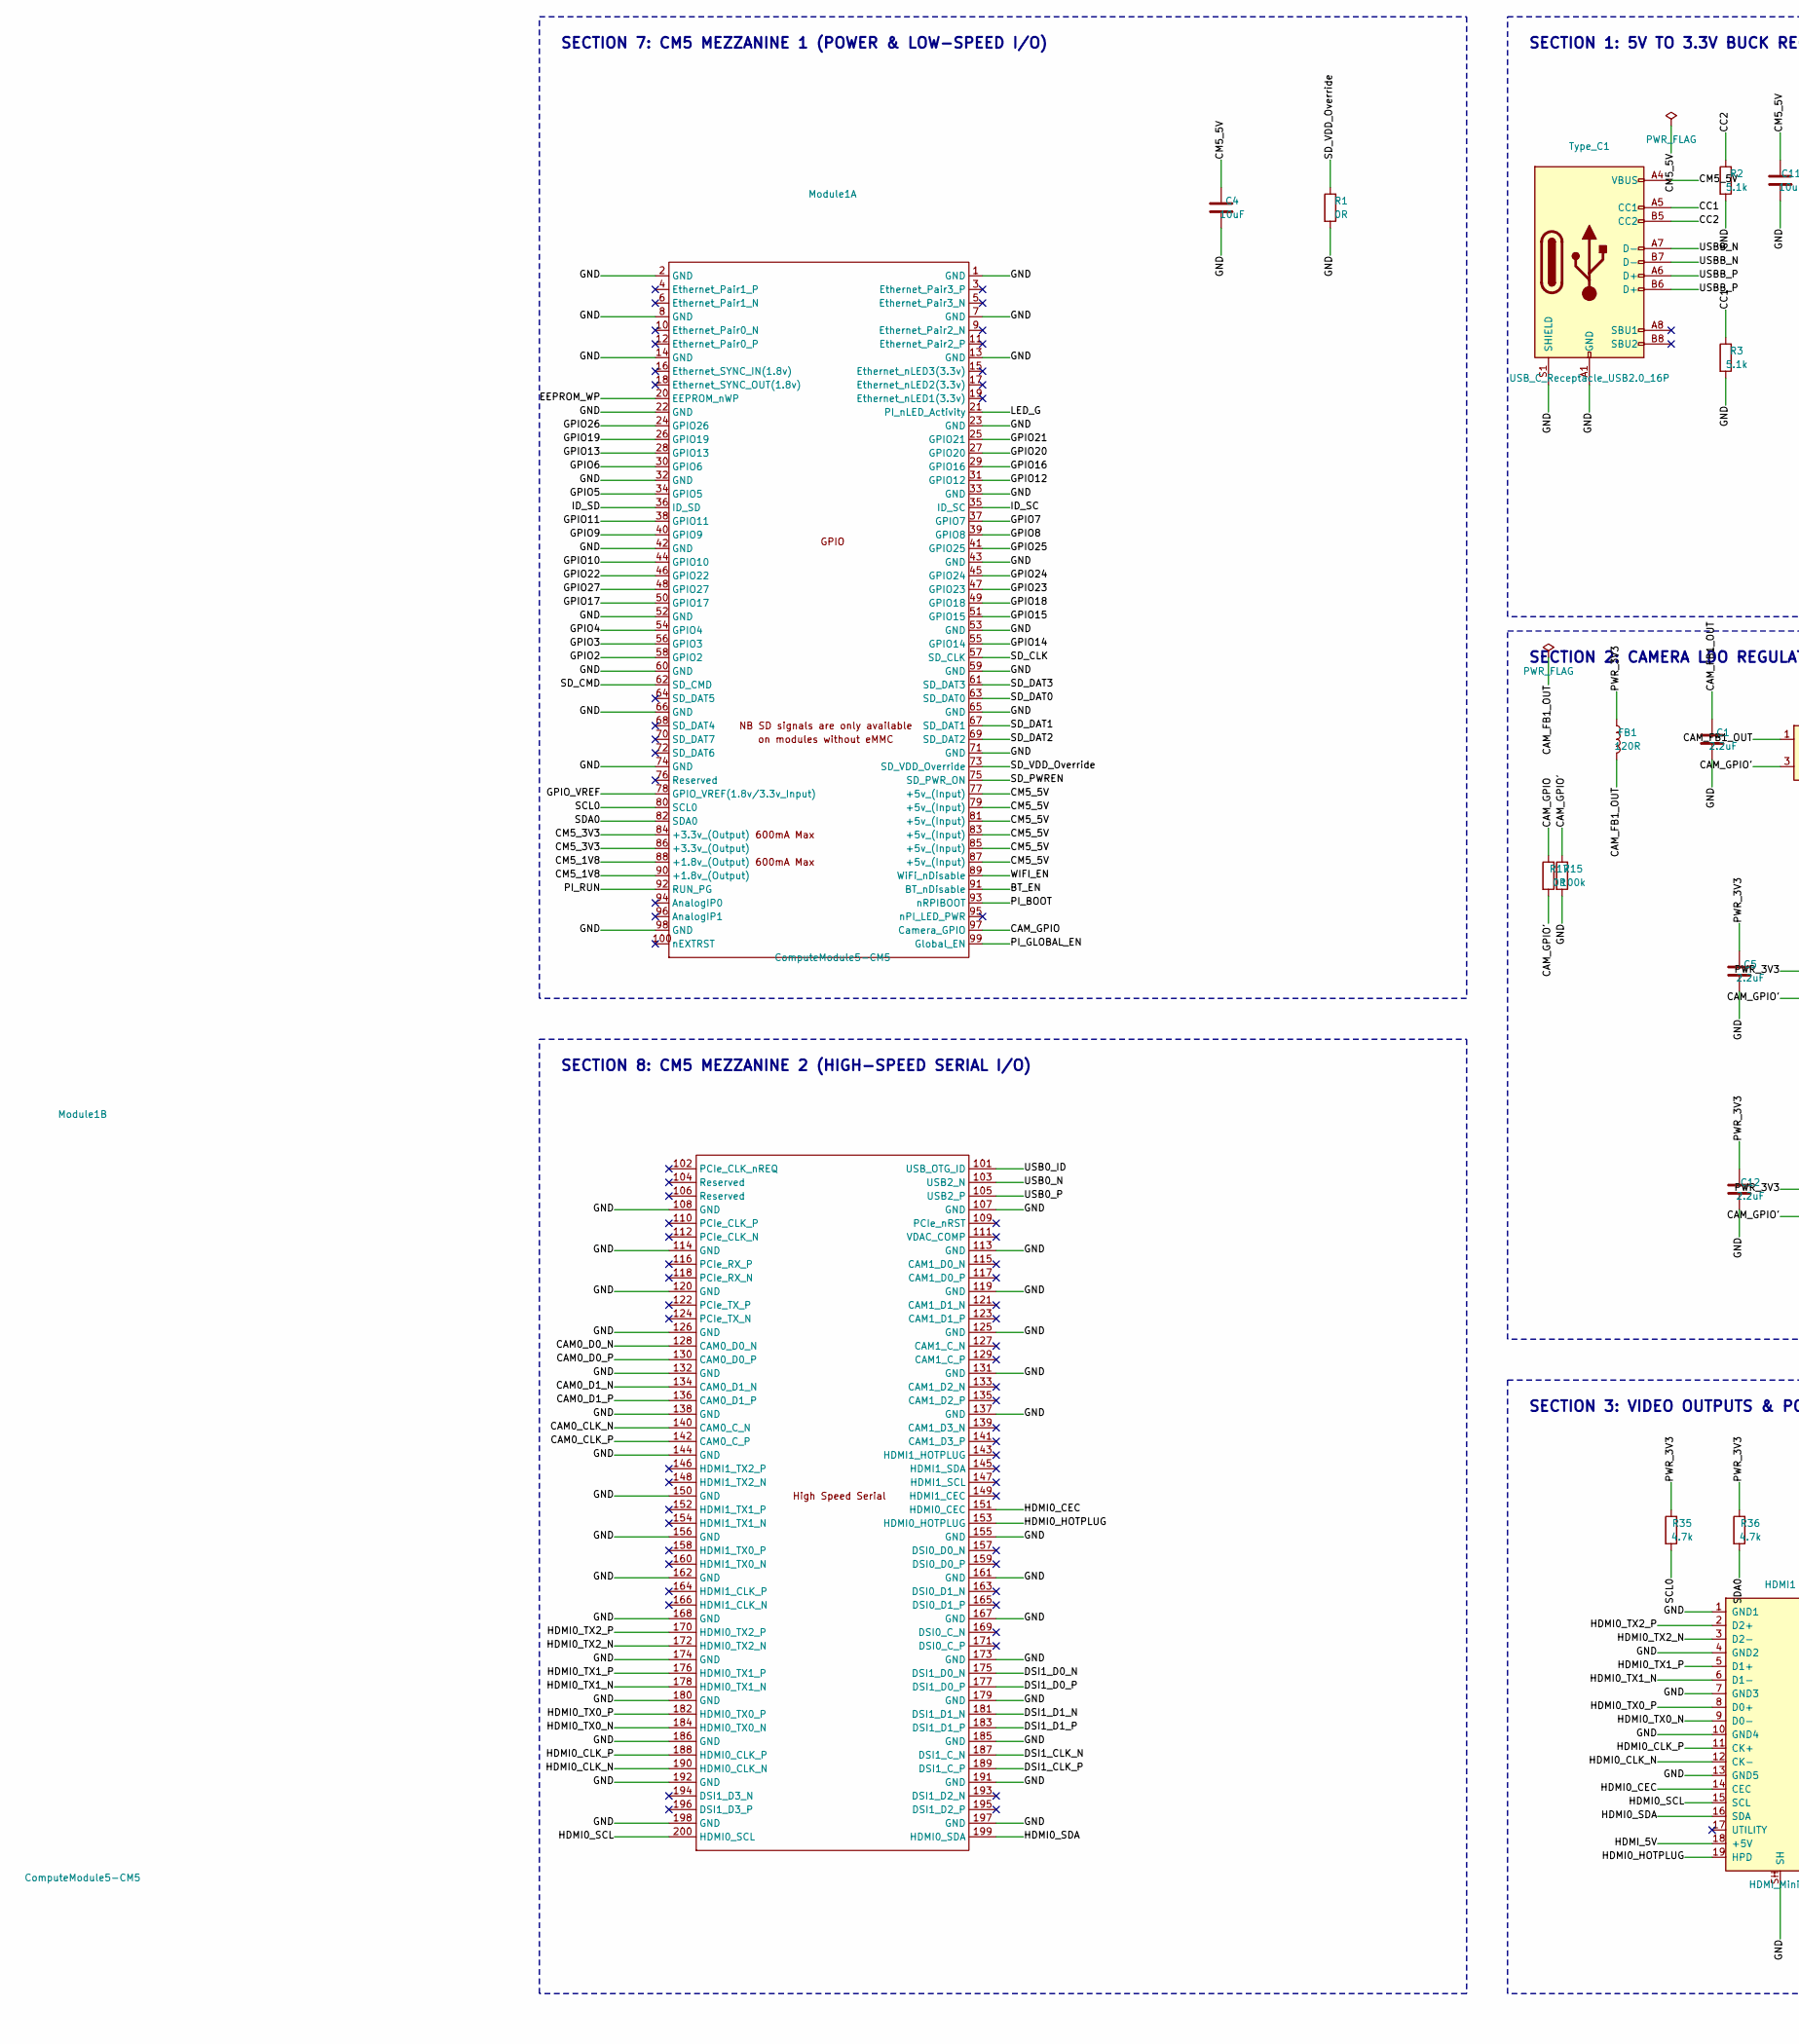
[picture p34: schematic CM5-AI-Cam-CopperPilot.kicad_sch, CM5 AI Camera Carrier Board, part in row 1, column 1]

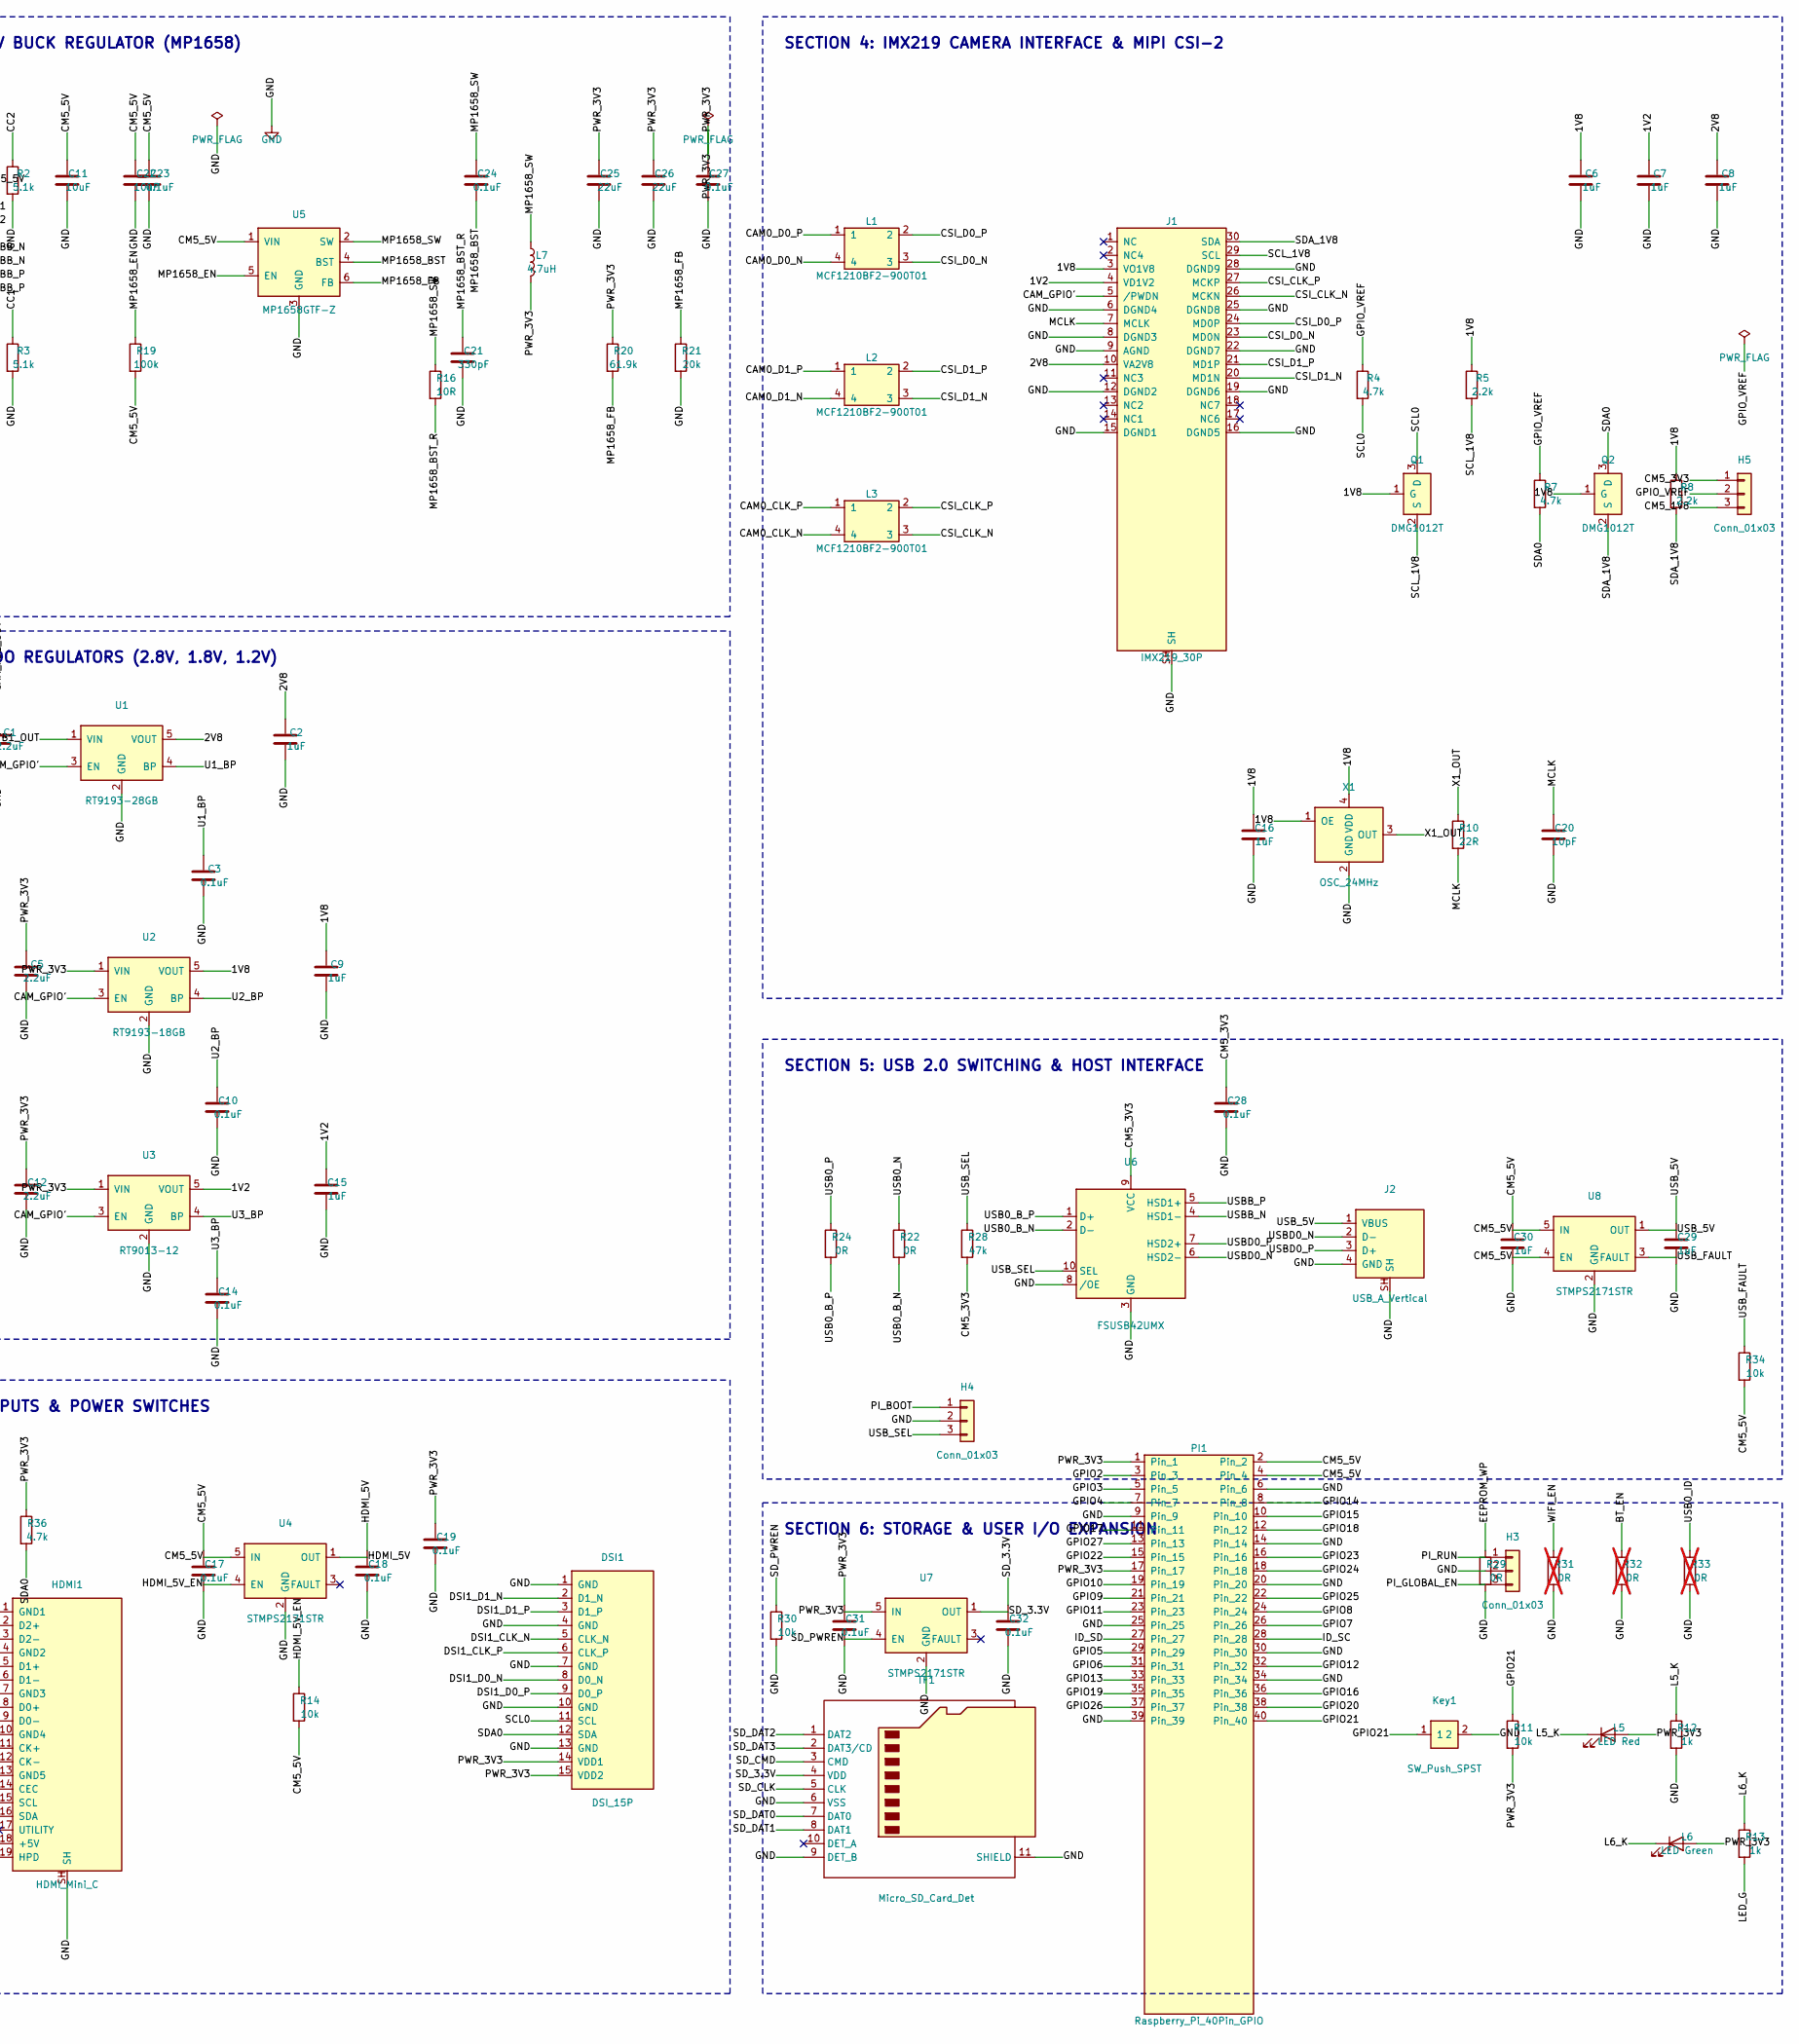
[picture p35: schematic CM5-AI-Cam-CopperPilot.kicad_sch, CM5 AI Camera Carrier Board, part in row 1, column 2]

Parts:
C1, C5, C12: 2.2uF; C_0402_1005Metric; LCSC C23733
C2, C6, C7, C8, C9, C15, C16, C29, C30: 1uF; C_0402_1005Metric; LCSC C52923
C3, C10, C14, C17, C18, C19, C23, C24, C27, C28, C31, C32: 0.1uF; C_0402_1005Metric; LCSC C1525
C4, C11, C22: 10uF; C_0805_2012Metric; LCSC C15850
C20: 10pF; C_0402_1005Metric; LCSC C32949
C21: 330pF; C_0402_1005Metric; LCSC C1534
C25, C26: 22uF; C_0805_2012Metric; LCSC C45783
DSI1: DSI_15P; Molex_200528-0150_1x15-1MP_P1.00mm_Horizontal; LCSC C2914074
FB1: 120R; R_0603_1608Metric; LCSC C50843
H3, H4, H5: Conn_01x03; PinHeader_1x03_P2.54mm_Vertical; LCSC C49257
HDMI1: HDMI_Mini_C; HDMI_Mini-C_Molex_47151-0001; LCSC C424662
J1: IMX219_30P; Camera_Module_IMX219-D160; LCSC C6539772
J2: USB_A_Vertical; MOLEX_USB_67298-4090; LCSC C698207
Key1: SW_Push_SPST; SW_SPST_PTS645Sx43SMTR92; LCSC C318884
L1, L2, L3: MCF1210BF2-900T01; L_CommonModeChoke_Coilank_ACM1210; LCSC C110443
L5: LED Red; LED_0603_1608Metric; LCSC C2286
L6: LED Green; LED_0603_1608Metric; LCSC C72043
L7: 4.7uH; L_Bourns_SRP5030CC; LCSC C840574
Module1: ComputeModule5-CM5; Raspberry-Pi-5-Compute-Module; LCSC C597931
PI1: Raspberry_Pi_40Pin_GPIO; PinHeader_2x20_P2.54mm_Vertical; LCSC C50980
Q1, Q2: DMG1012T; SOT-523; LCSC C20512
R1, R17, R22, R24, R29: 0R; R_0402_1005Metric; LCSC C17168
R2, R3: 5.1k; R_0402_1005Metric; LCSC C25905
R4, R7, R35, R36: 4.7k; R_0402_1005Metric; LCSC C25900
R5, R8: 2.2k; R_0402_1005Metric; LCSC C25879
R10: 22R; R_0402_1005Metric; LCSC C25092
R11, R14, R30, R34: 10k; R_0402_1005Metric; LCSC C25744
R12, R13: 1k; R_0402_1005Metric; LCSC C11702
R15, R19: 100k; R_0402_1005Metric; LCSC C25741
R16: 10R; R_0402_1005Metric; LCSC C25077
R20: 61.9k; R_0402_1005Metric; LCSC C25803
R21: 20k; R_0402_1005Metric; LCSC C25765
R28: 47k; R_0402_1005Metric; LCSC C25792
R31, R32, R33: 0R; R_0402_1005Metric; LCSC C17168; not fitted
TF1: Micro_SD_Card_Det; SDCARD_MOLEX_503398-1892; LCSC C91145
Type_C1: USB_C_Receptacle_USB2.0_16P; USB_C_Receptacle_GCT_USB4105-xx-A_16P_TopMnt_Horizontal; LCSC C3020560
U1: RT9193-28GB; SOT-23-5; LCSC C15075
U2: RT9193-18GB; SOT-23-5; LCSC C27416
U3: RT9013-12; SOT-23-5; LCSC C47773
U4, U7, U8: STMPS2171STR; SOT-23-5; LCSC C157437
U5: MP1658GTF-Z; SOT-563; LCSC C2960187
U6: FSUSB42UMX; UQFN-10_1.4x1.8mm_P0.4mm; LCSC C11145
X1: OSC_24MHz; Crystal_SMD_3225-4Pin_3.2x2.5mm; LCSC C717686

Connections:
/1V2: C7.1, C15.1, J1.4 (VD1V2), U3.5 (VOUT)
/1V8: C6.1, C9.1, C16.1, J1.3 (VO1V8), Q1.1 (G), Q2.1 (G), R5.1, R8.1, U2.5 (VOUT), X1.1 (OE), X1.4 (VDD)
/2V8: C2.1, C8.1, J1.10 (VA2V8), U1.5 (VOUT)
/BT_EN: Module1.91 (BT_nDisable), R32.1
/CAM0_CLK_N: L3.4, Module1.140 (CAM0_C_N)
/CAM0_CLK_P: L3.1, Module1.142 (CAM0_C_P)
/CAM0_D0_N: L1.4, Module1.128 (CAM0_D0_N)
/CAM0_D0_P: L1.1, Module1.130 (CAM0_D0_P)
/CAM0_D1_N: L2.4, Module1.134 (CAM0_D1_N)
/CAM0_D1_P: L2.1, Module1.136 (CAM0_D1_P)
/CAM_FB1_OUT: C1.1, FB1.2, U1.1 (VIN)
/CAM_GPIO: Module1.97 (Camera_GPIO), R17.1
/CAM_GPIO': J1.5 (/PWDN), R15.1, R17.2, U1.3 (EN), U2.3 (EN), U3.3 (EN)
/CC1: R3.1, Type_C1.A5 (CC1)
/CC2: R2.1, Type_C1.B5 (CC2)
/CM5_1V8: H5.3, Module1.88 (+1.8v_(Output)), Module1.90 (+1.8v_(Output))
/CM5_3V3: C28.1, H5.1, Module1.84 (+3.3v_(Output)), Module1.86 (+3.3v_(Output)), R28.2, U6.9 (VCC)
/CM5_5V: C4.1, C11.1, C17.1, C22.1, C23.1, C30.1, Module1.77 (+5v_(Input)), Module1.79 (+5v_(Input)), Module1.81 (+5v_(Input)), Module1.83 (+5v_(Input)), Module1.85 (+5v_(Input)), Module1.87 (+5v_(Input)), PI1.2, PI1.4, R14.2, R19.2, R34.2, Type_C1.A4 (VBUS), Type_C1.A9 (VBUS), Type_C1.B4 (VBUS), Type_C1.B9 (VBUS), U4.5 (IN), U5.1 (VIN), U8.4 (EN), U8.5 (IN)
/CSI_CLK_N: J1.26 (MCKN), L3.3
/CSI_CLK_P: J1.27 (MCKP), L3.2
/CSI_D0_N: J1.23 (MD0N), L1.3
/CSI_D0_P: J1.24 (MD0P), L1.2
/CSI_D1_N: J1.20 (MD1N), L2.3
/CSI_D1_P: J1.21 (MD1P), L2.2
/DSI1_CLK_N: DSI1.5 (CLK_N), Module1.187 (DSI1_C_N)
/DSI1_CLK_P: DSI1.6 (CLK_P), Module1.189 (DSI1_C_P)
/DSI1_D0_N: DSI1.8 (D0_N), Module1.175 (DSI1_D0_N)
/DSI1_D0_P: DSI1.9 (D0_P), Module1.177 (DSI1_D0_P)
/DSI1_D1_N: DSI1.2 (D1_N), Module1.181 (DSI1_D1_N)
/DSI1_D1_P: DSI1.3 (D1_P), Module1.183 (DSI1_D1_P)
/EEPROM_WP: Module1.20 (EEPROM_nWP), R29.1
/GPIO2: Module1.58 (GPIO2), PI1.3
/GPIO3: Module1.56 (GPIO3), PI1.5
/GPIO4: Module1.54 (GPIO4), PI1.7
/GPIO5: Module1.34 (GPIO5), PI1.29
/GPIO6: Module1.30 (GPIO6), PI1.31
/GPIO7: Module1.37 (GPIO7), PI1.26
/GPIO8: Module1.39 (GPIO8), PI1.24
/GPIO9: Module1.40 (GPIO9), PI1.21
/GPIO10: Module1.44 (GPIO10), PI1.19
/GPIO11: Module1.38 (GPIO11), PI1.23
/GPIO12: Module1.31 (GPIO12), PI1.32
/GPIO13: Module1.28 (GPIO13), PI1.33
/GPIO14: Module1.55 (GPIO14), PI1.8
/GPIO15: Module1.51 (GPIO15), PI1.10
/GPIO16: Module1.29 (GPIO16), PI1.36
/GPIO17: Module1.50 (GPIO17), PI1.11
/GPIO18: Module1.49 (GPIO18), PI1.12
/GPIO19: Module1.26 (GPIO19), PI1.35
/GPIO20: Module1.27 (GPIO20), PI1.38
/GPIO21: Key1.1, Module1.25 (GPIO21), PI1.40, R11.1
/GPIO22: Module1.46 (GPIO22), PI1.15
/GPIO23: Module1.47 (GPIO23), PI1.16
/GPIO24: Module1.45 (GPIO24), PI1.18
/GPIO25: Module1.41 (GPIO25), PI1.22
/GPIO26: Module1.24 (GPIO26), PI1.37
/GPIO27: Module1.48 (GPIO27), PI1.13
/GPIO_VREF: H5.2, Module1.78 (GPIO_VREF(1.8v/3.3v_Input)), R4.1, R7.1
/HDMI0_CEC: HDMI1.14 (CEC), Module1.151 (HDMI0_CEC)
/HDMI0_CLK_N: HDMI1.12 (CK-), Module1.190 (HDMI0_CLK_N)
/HDMI0_CLK_P: HDMI1.11 (CK+), Module1.188 (HDMI0_CLK_P)
/HDMI0_HOTPLUG: HDMI1.19 (HPD), Module1.153 (HDMI0_HOTPLUG)
/HDMI0_SCL: HDMI1.15 (SCL), Module1.200 (HDMI0_SCL)
/HDMI0_SDA: HDMI1.16 (SDA), Module1.199 (HDMI0_SDA)
/HDMI0_TX0_N: HDMI1.9 (D0-), Module1.184 (HDMI0_TX0_N)
/HDMI0_TX0_P: HDMI1.8 (D0+), Module1.182 (HDMI0_TX0_P)
/HDMI0_TX1_N: HDMI1.6 (D1-), Module1.178 (HDMI0_TX1_N)
/HDMI0_TX1_P: HDMI1.5 (D1+), Module1.176 (HDMI0_TX1_P)
/HDMI0_TX2_N: HDMI1.3 (D2-), Module1.172 (HDMI0_TX2_N)
/HDMI0_TX2_P: HDMI1.2 (D2+), Module1.170 (HDMI0_TX2_P)
/HDMI_5V: C18.1, HDMI1.18 (+5V), U4.1 (OUT)
/HDMI_5V_EN: R14.1, U4.4 (EN)
/ID_SC: Module1.35 (ID_SC), PI1.28
/ID_SD: Module1.36 (ID_SD), PI1.27
/L5_K: L5.1 (K), R12.1
/L6_K: L6.1 (K), R13.1
/LED_G: Module1.21 (PI_nLED_Activity), R13.2
/MCLK: C20.1, J1.7 (MCLK), R10.2
/MP1658_BST: C24.2, U5.4 (BST)
/MP1658_BST_R: C21.1, R16.2
/MP1658_EN: R19.1, U5.5 (EN)
/MP1658_FB: R20.2, R21.1, U5.6 (FB)
/MP1658_SW: C24.1, L7.1, R16.1, U5.2 (SW)
/PI_BOOT: H4.1, Module1.93 (nRPIBOOT)
/PI_GLOBAL_EN: H3.3, Module1.99 (Global_EN)
/PI_RUN: H3.1, Module1.92 (RUN_PG)
/PWR_3V3: C5.1, C12.1, C19.1, C25.1, C26.1, C27.1, C31.1, DSI1.14 (VDD1), DSI1.15 (VDD2), FB1.1, L5.2 (A), L6.2 (A), L7.2, PI1.1, PI1.17, R11.2, R20.1, R35.1, R36.1, U2.1 (VIN), U3.1 (VIN), U7.5 (IN)
/SCL0: DSI1.11 (SCL), Module1.80 (SCL0), Q1.3 (D), R4.2, R35.2
/SCL_1V8: J1.29 (SCL), Q1.2 (S), R5.2
/SDA0: DSI1.12 (SDA), Module1.82 (SDA0), Q2.3 (D), R7.2, R36.2
/SDA_1V8: J1.30 (SDA), Q2.2 (S), R8.2
/SD_3.3V: C32.1, TF1.4 (VDD), U7.1 (OUT)
/SD_CLK: Module1.57 (SD_CLK), TF1.5 (CLK)
/SD_CMD: Module1.62 (SD_CMD), TF1.3 (CMD)
/SD_DAT0: Module1.63 (SD_DAT0), TF1.7 (DAT0)
/SD_DAT1: Module1.67 (SD_DAT1), TF1.8 (DAT1)
/SD_DAT2: Module1.69 (SD_DAT2), TF1.1 (DAT2)
/SD_DAT3: Module1.61 (SD_DAT3), TF1.2 (DAT3/CD)
/SD_PWREN: Module1.75 (SD_PWR_ON), R30.1, U7.4 (EN)
/SD_VDD_Override: Module1.73 (SD_VDD_Override), R1.1
/U1_BP: C3.1, U1.4 (BP)
/U2_BP: C10.1, U2.4 (BP)
/U3_BP: C14.1, U3.4 (BP)
/USB0_B_N: R22.2, U6.2 (D-)
/USB0_B_P: R24.2, U6.1 (D+)
/USB0_ID: Module1.101 (USB_OTG_ID), R33.1
/USB0_N: Module1.103 (USB2_N), R22.1
/USB0_P: Module1.105 (USB2_P), R24.1
/USBB_N: Type_C1.A7 (D-), Type_C1.B7 (D-), U6.4 (HSD1-)
/USBB_P: Type_C1.A6 (D+), Type_C1.B6 (D+), U6.5 (HSD1+)
/USBD0_N: J2.2 (D-), U6.6 (HSD2-)
/USBD0_P: J2.3 (D+), U6.7 (HSD2+)
/USB_5V: C29.1, J2.1 (VBUS), U8.1 (OUT)
/USB_FAULT: R34.1, U8.3 (FAULT)
/USB_SEL: H4.3, R28.1, U6.10 (SEL)
/WIFI_EN: Module1.89 (WiFi_nDisable), R31.1
/X1_OUT: R10.1, X1.3 (OUT)
GND: C1.2, C2.2, C3.2, C4.2, C5.2, C6.2, C7.2, C8.2, C9.2, C10.2, C11.2, C12.2, C14.2, C15.2, C16.2, C17.2, C18.2, C19.2, C20.2, C21.2, C22.2, C23.2, C25.2, C26.2, C27.2, C28.2, C29.2, C30.2, C31.2, C32.2, DSI1.1 (GND), DSI1.4 (GND), DSI1.7 (GND), DSI1.10 (GND), DSI1.13 (GND), H3.2, H4.2, HDMI1.1 (GND1), HDMI1.4 (GND2), HDMI1.7 (GND3), HDMI1.10 (GND4), HDMI1.13 (GND5), HDMI1.SH, J1.6 (DGND4), J1.8 (DGND3), J1.9 (AGND), J1.12 (DGND2), J1.15 (DGND1), J1.16 (DGND5), J1.19 (DGND6), J1.22 (DGND7), J1.25 (DGND8), J1.28 (DGND9), J1.SH, J2.4 (GND), J2.SH, Key1.2, Module1.1 (GND), Module1.2 (GND), Module1.7 (GND), Module1.8 (GND), Module1.13 (GND), Module1.14 (GND), Module1.22 (GND), Module1.23 (GND), Module1.32 (GND), Module1.33 (GND), Module1.42 (GND), Module1.43 (GND), Module1.52 (GND), Module1.53 (GND), Module1.59 (GND), Module1.60 (GND), Module1.65 (GND), Module1.66 (GND), Module1.71 (GND), Module1.74 (GND), Module1.98 (GND), Module1.107 (GND), Module1.108 (GND), Module1.113 (GND), Module1.114 (GND), Module1.119 (GND), Module1.120 (GND), Module1.125 (GND), Module1.126 (GND), Module1.131 (GND), Module1.132 (GND), Module1.137 (GND), Module1.138 (GND), Module1.144 (GND), Module1.150 (GND), Module1.155 (GND), Module1.156 (GND), Module1.161 (GND), Module1.162 (GND), Module1.167 (GND), Module1.168 (GND), Module1.173 (GND), Module1.174 (GND), Module1.179 (GND), Module1.180 (GND), Module1.185 (GND), Module1.186 (GND), Module1.191 (GND), Module1.192 (GND), Module1.197 (GND), Module1.198 (GND), PI1.6, PI1.9, PI1.14, PI1.20, PI1.25, PI1.30, PI1.34, PI1.39, R1.2, R2.2, R3.2, R12.2, R15.2, R21.2, R29.2, R30.2, R31.2, R32.2, R33.2, TF1.6 (VSS), TF1.9 (DET_B), TF1.11 (SHIELD), Type_C1.A1 (GND), Type_C1.A12 (GND), Type_C1.B1 (GND), Type_C1.B12 (GND), Type_C1.S1 (SHIELD), U1.2 (GND), U2.2 (GND), U3.2 (GND), U4.2 (GND), U5.3 (GND), U6.3 (GND), U6.8 (/OE), U7.2 (GND), U8.2 (GND), X1.2 (GND)

Notes on the sheet:
SECTION 1: 5V TO 3.3V BUCK REGULATOR (MP1658)
SECTION 2: CAMERA LDO REGULATORS (2.8V, 1.8V, 1.2V)
SECTION 3: VIDEO OUTPUTS & POWER SWITCHES
SECTION 4: IMX219 CAMERA INTERFACE & MIPI CSI-2
SECTION 5: USB 2.0 SWITCHING & HOST INTERFACE
SECTION 6: STORAGE & USER I/O EXPANSION
SECTION 7: CM5 MEZZANINE 1 (POWER & LOW-SPEED I/O)
SECTION 8: CM5 MEZZANINE 2 (HIGH-SPEED SERIAL I/O)

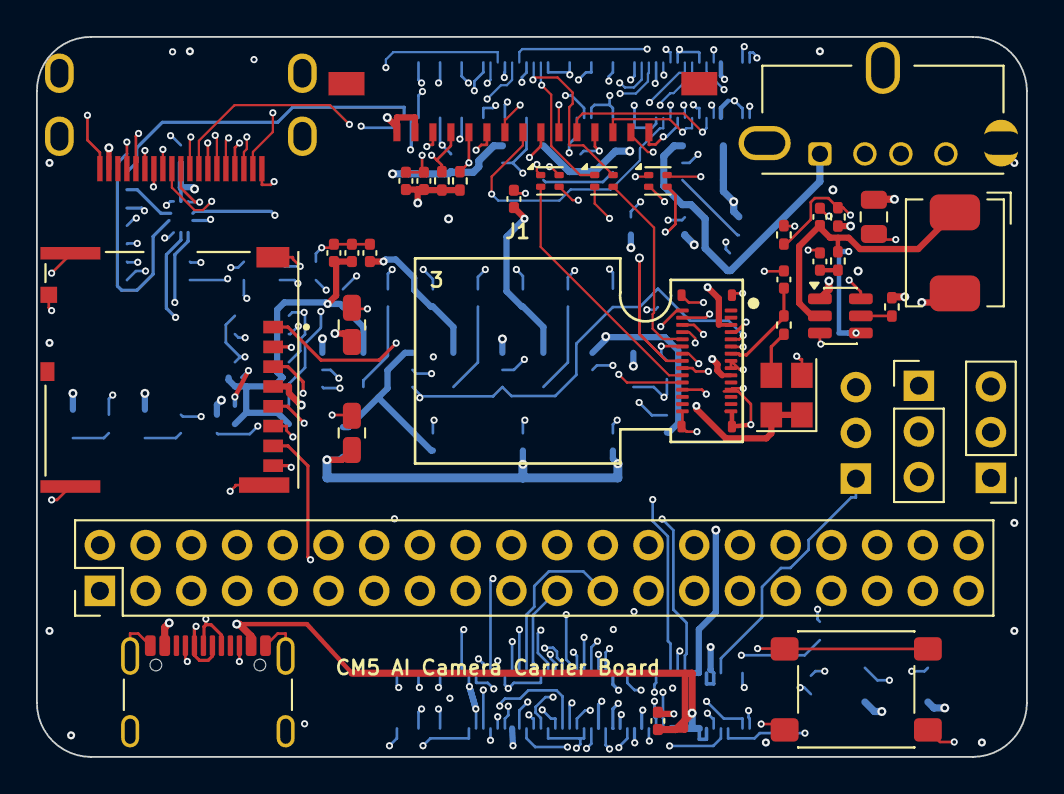
[picture p36: board CM5-AI-Cam-CopperPilot.kicad_pcb from above]

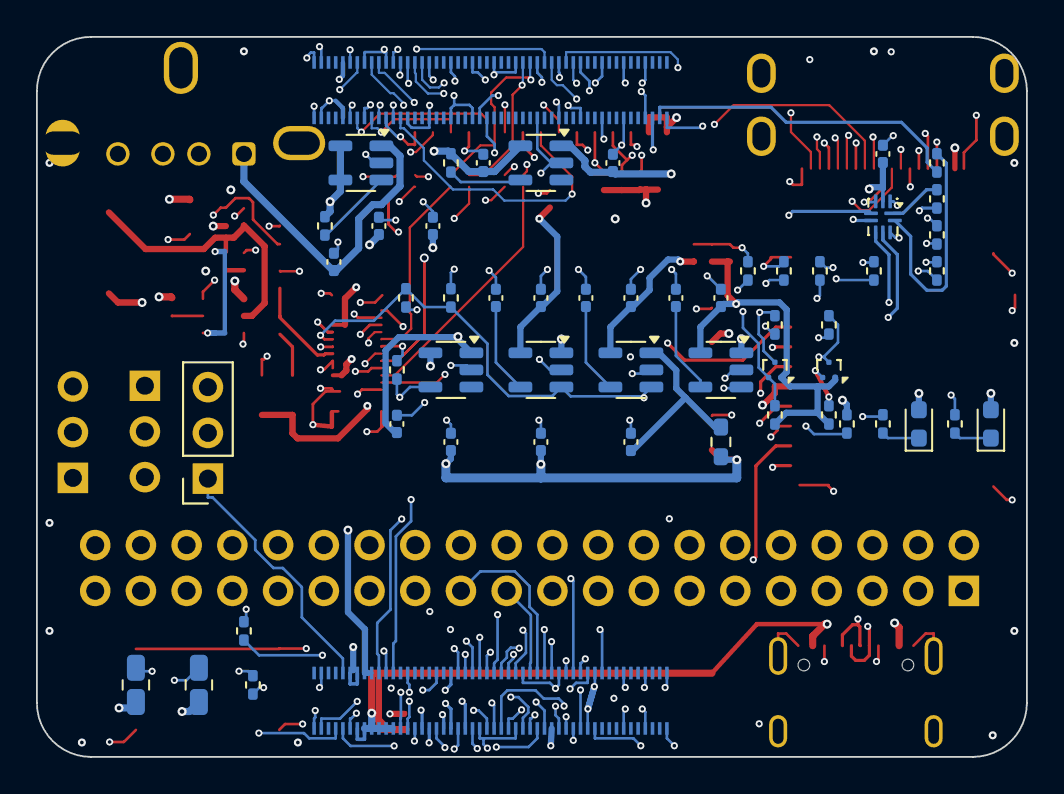
[picture p37: board CM5-AI-Cam-CopperPilot.kicad_pcb from below]

Board: 6 copper layers, 55.0 x 40.0 mm, 90 parts (54 on the bottom side), 118 nets.
