CopperPilot/CM5-AI-Cam-CopperPilot/(commit log)

2026-10-20 fix(hardware): separate 100R MIPI/HDMI and 90R USB netclasses and resolve BOM/SCH/PCB review defects
    - Assign HighSpeed_100R (100 Ohm diff: W=0.127mm, S=0.150mm -> 100.1 Ohm on JLC06161H-7628 stripline / 98.3 Ohm on JLC06161H-3313 microstrip) to MIPI CSI-2, MIPI DSI, and HDMI TMDS pairs, and HighSpeed_90R (90 Ohm diff: W=0.180mm, S=0.150mm -> 89.6 Ohm stripline / 88.7 Ohm microstrip) to USB 2.0 pairs in .kicad_pro, .kicad_pcb, and .kicad_dru.
    - Synchronize .kicad_pcb stackup dielectric parameters with JLCPCB JLC06161H-7628 (0.2104mm prepreg, 0.4000mm core, er=4.6).
    - Restore C20 on 24 MHz camera MCLK from 0.1uF (72.3 kHz cutoff) to 10pF (C32949, fc=723 MHz) and correct LCSC codes for R20 (C2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
    [CM5-AI-Cam-CopperPilot-B_Cu.gbl, CM5-AI-Cam-CopperPilot-B_Mask.gbs, CM5-AI-Cam-CopperPilot-B_Paste.gbp, CM5-AI-Cam-CopperPilot-B_Silkscreen.gbo, CM5-AI-Cam-CopperPilot-Edge_Cuts.gm1, CM5-AI-Cam-CopperPilot-F_Cu.gtl, CM5-AI-Cam-CopperPilot-F_Mask.gts, CM5-AI-Cam-CopperPilot-F_Paste.gtp]
2026-10-20 docs(review): update impedance specs, ORDER_SPEC, and visual diff review artifacts
    - Update README.md and manufacturing/ORDER_SPEC.md to specify 100 Ohm differential impedance for MIPI CSI-2, MIPI DSI, and HDMI TMDS and 90 Ohm differential impedance for USB 2.0 with complete JLCPCB stackup tables.
    - Synchronize review/DECISIONS.md, review/SURVEY.md, review/READINESS.md, review/ISSUES.md, review/issues.json, review/index.html, and before/after/diff render crops.
