CopperPilot/CM5-AI-Cam-CopperPilot/(notices)

Notices in the files:
README.md:
License: CERN-OHL-S-2.0
